RicardoKers/TelemetriaVeiculoEletrico/README.md

# TelemetriaVeiculoEletrico

Projeto da telemetria do veículo elétrico do IFC Luzerna versão 2022
