RicardoKers/TelemetriaVeiculoEletrico/Documentos/Características das entradas.docx

Entradas de tensão

Circuito de teste

Resposta no tempo.

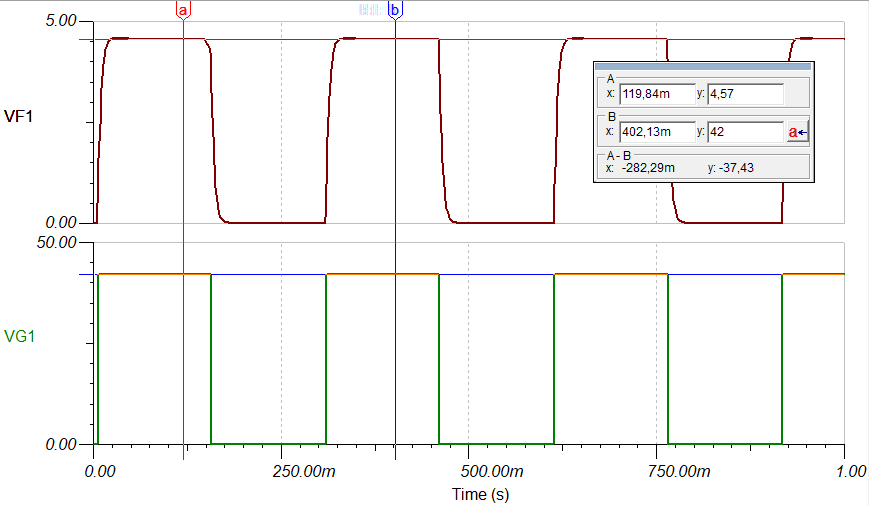
[picture p1: figure]

Resposta em frequência.

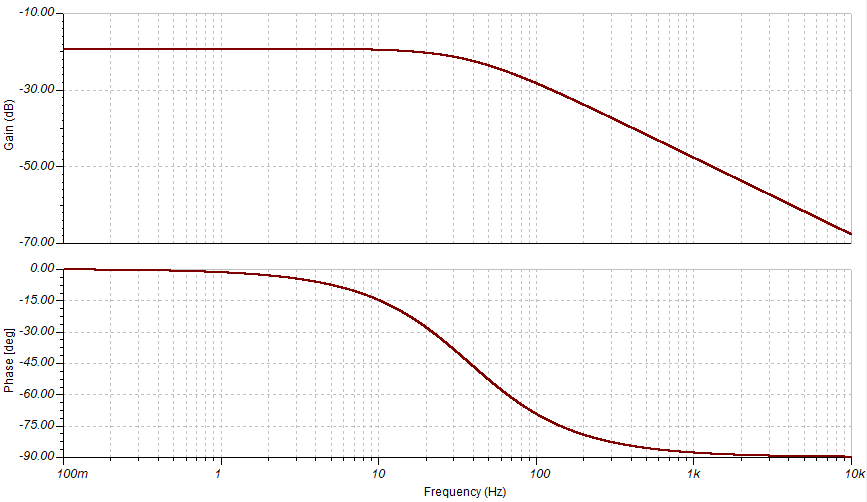
[picture p2: figure]

Entrada de corrente:

Circuito de teste:

Resposta no tempo:

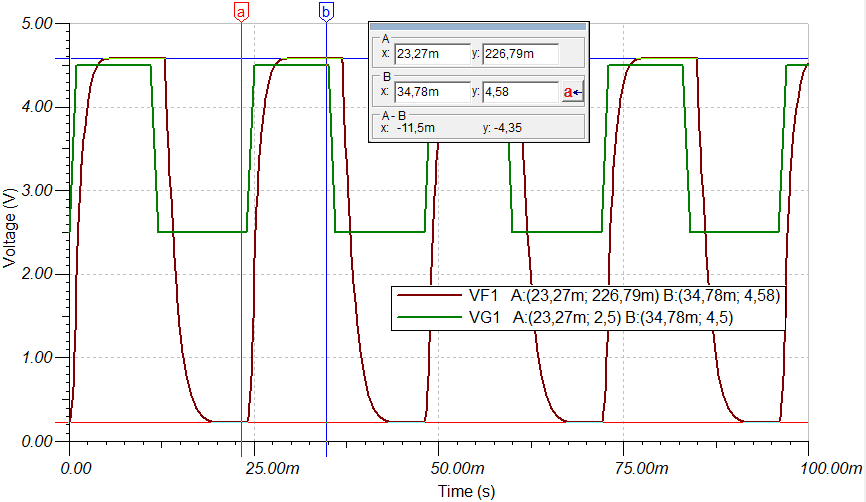
[picture p3: figure]

Resposta em frequência:

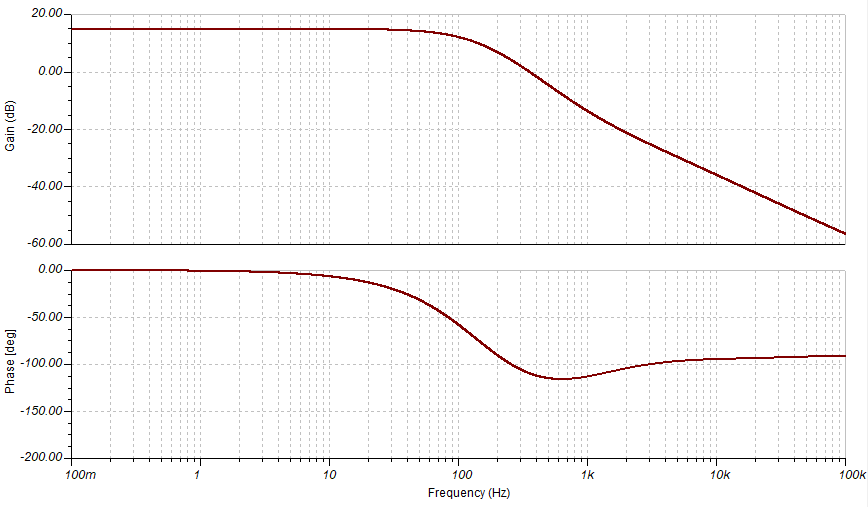
[picture p4: figure]
