RicardoKers/TelemetriaVeiculoEletrico/simulacao/BLDC.png

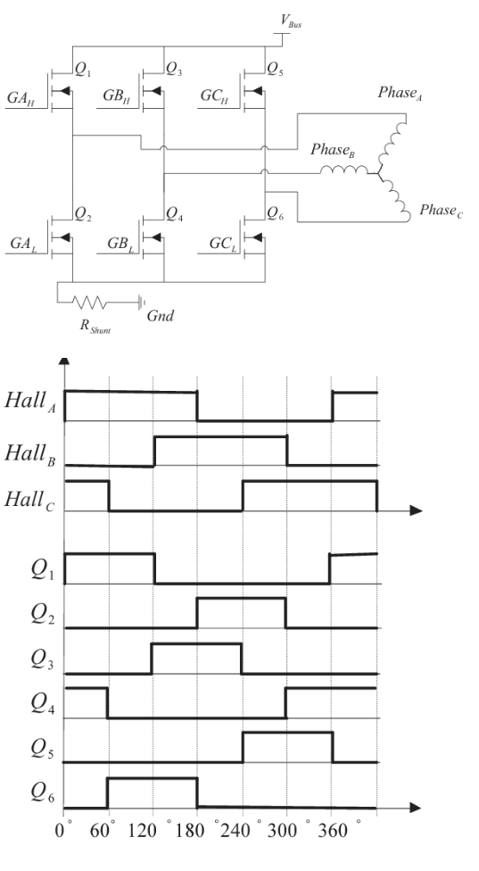
simulacao/BLDC.png
