RicardoKers/TelemetriaVeiculoEletrico/Documentos/Projeto LM2576.pdf

## WEBENCH ® Design Report

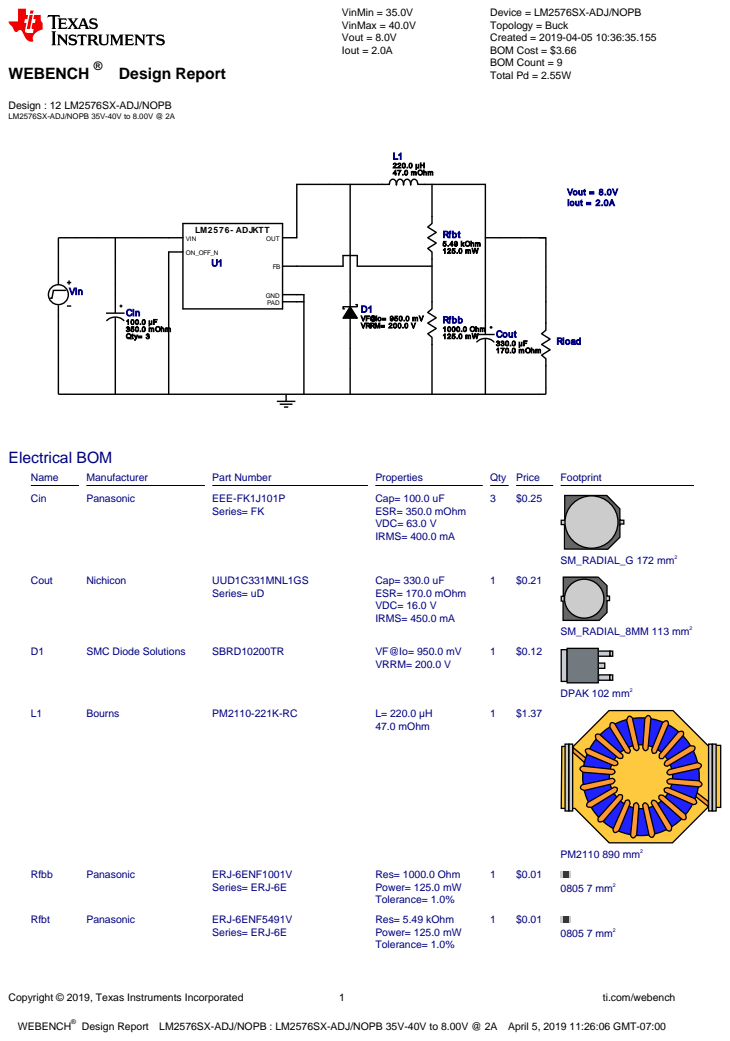
[picture p11: page 1]
Copyright © 2019, Texas Instruments Incorporated; ti.com/webench; WEBENCH®; VinMin = 35.0V VinMax = 40.0V Vout = 8.0V Iout = 2.0A; Cin 100.0 µF 350.0 mOhm; Qty= 3; Cout; 330.0 µF 170.0 mOhm; D1 VF@Io= 950.0 mV VRRM= 200.0 V; L1 220.0 µH 47.0 mOhm; Rfbb 1000.0 Ohm 125.0 mW; Rfbt 5.49 kOhm 125.0 mW; LM2576- ADJKTT; VIN; OUT; GND; ON_OFF_N; PAD; Vout = 8.0V Iout = 2.0A; Vin; Rload; Electrical BOM; Name; Manufacturer; Part Number; Properties; Qty Price; Footprint; Cin; Panasonic; EEE-FK1J101P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

Device = LM2576SX-ADJ/NOPB
Topology = Buck
Created = 2019-04-05 10:36:35.155
BOM Cost = $3.66
BOM Count = 9
Total Pd = 2.55W

Design : 12 LM2576SX-ADJ/NOPB
LM2576SX-ADJ/NOPB 35V-40V to 8.00V @ 2A

Design Report LM2576SX-ADJ/NOPB : LM2576SX-ADJ/NOPB 35V-40V to 8.00V @ 2A April 5, 2019 11:26:06 GMT-07:00

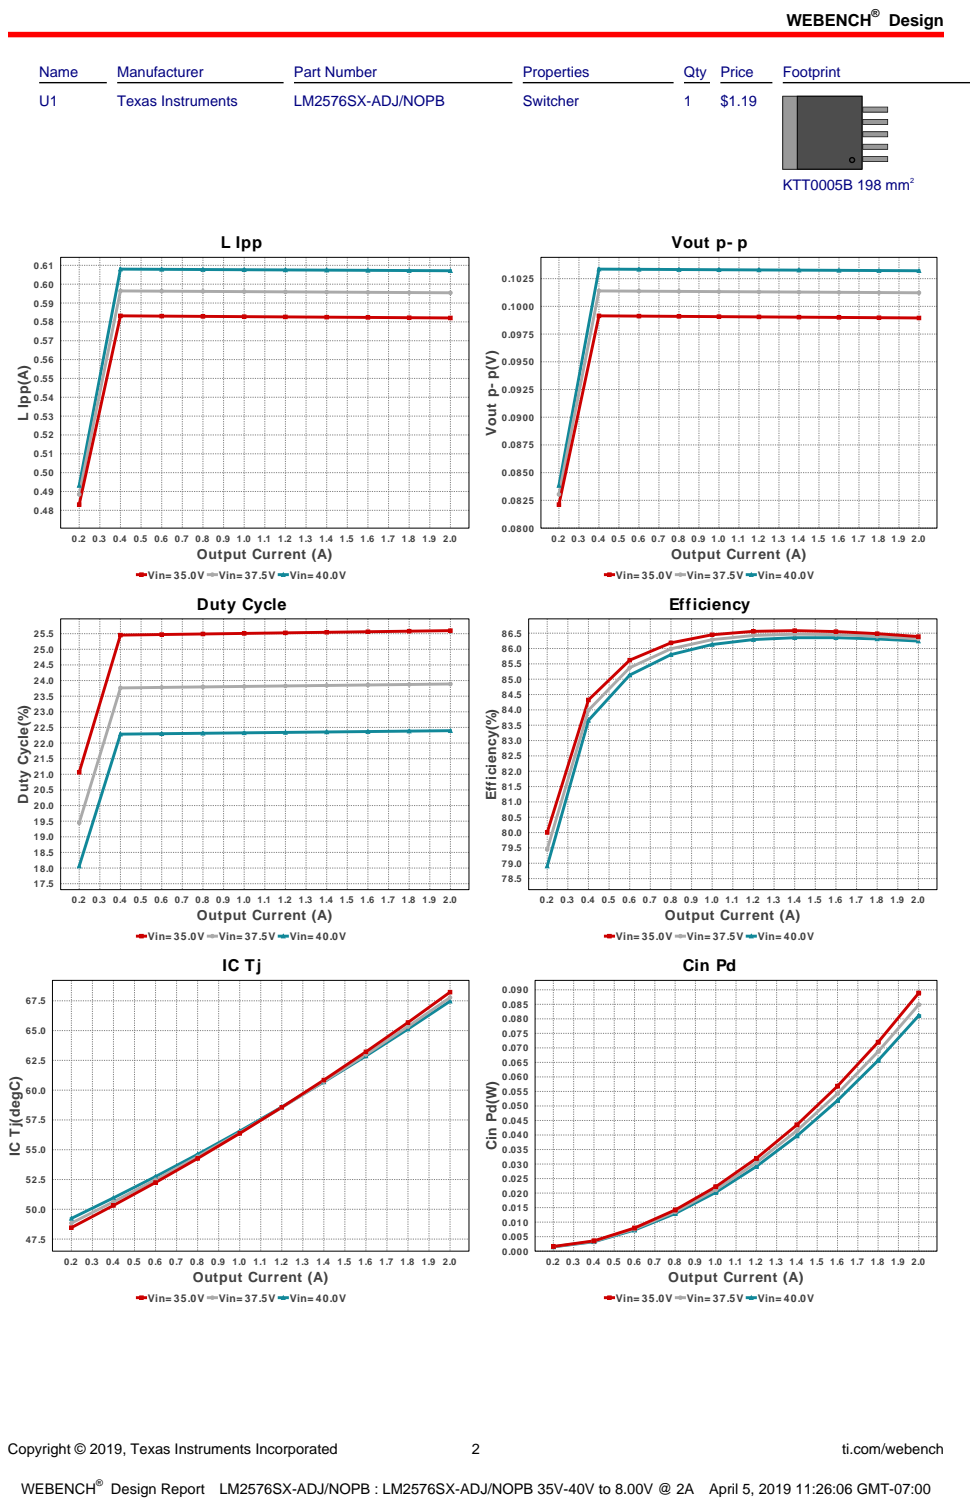
[picture p12: page 2]
Design; Copyright © 2019, Texas Instruments Incorporated; ti.com/webench; Name; Manufacturer; Part Number; Properties; Qty Price; Footprint; Texas Instruments; LM2576SX-ADJ/NOPB; Switcher; KTT0005B 198 mm²; L Ipp; 0.2 0.3 0.4 0.5 0.6 0.7 0.8 0.9 1.0 1.1 1.2 1.3 1.4 1.5 1.6 1.7 1.8 1.9 2.0 Output Current (A); L Ipp(A); Vout p- p; Vout p- p(V); Duty Cycle(%); Efficiency(%); Cin Pd; Cin Pd(W)

Vin= 35.0V Vin= 37.5V Vin= 40.0V
Duty Cycle

Efficiency

IC Tj(degC)

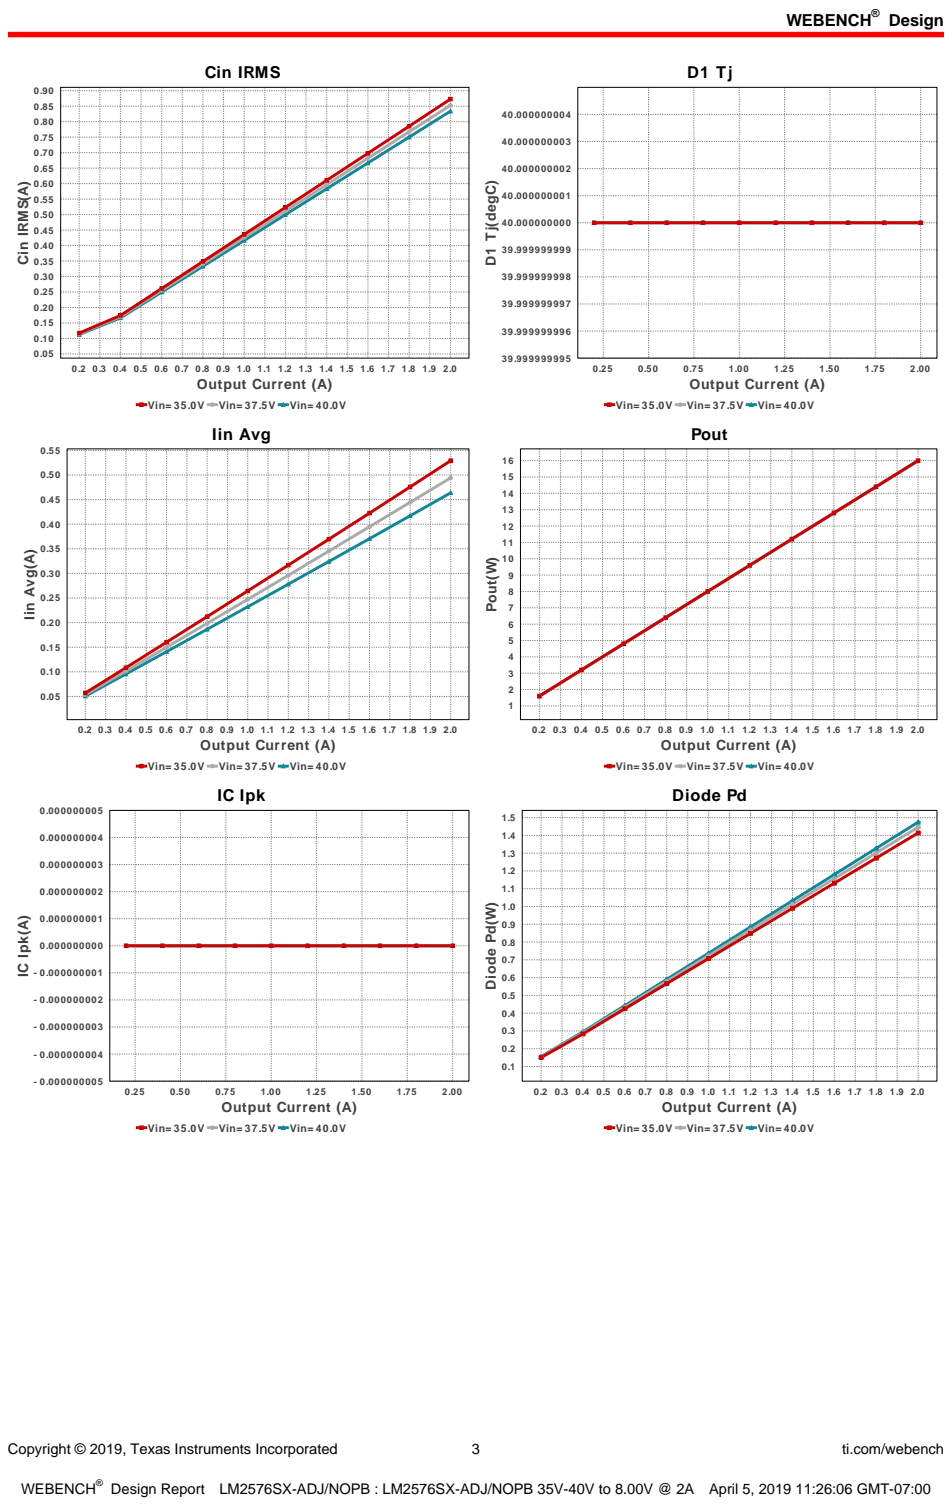
[picture p13: page 3]
Copyright © 2019, Texas Instruments Incorporated; ti.com/webench; Cin IRMS; 0.2 0.3 0.4 0.5 0.6 0.7 0.8 0.9 1.0 1.1 1.2 1.3 1.4 1.5 1.6 1.7 1.8 1.9 2.0 Output Current (A); Cin IRMS(A); 2.00 Output Current (A); D1 Tj(degC); Iin Avg; Iin Avg(A); Pout; Pout(W); IC Ipk; IC Ipk(A); Diode Pd(W)

Vin= 35.0V Vin= 37.5V Vin= 40.0V

Diode Pd

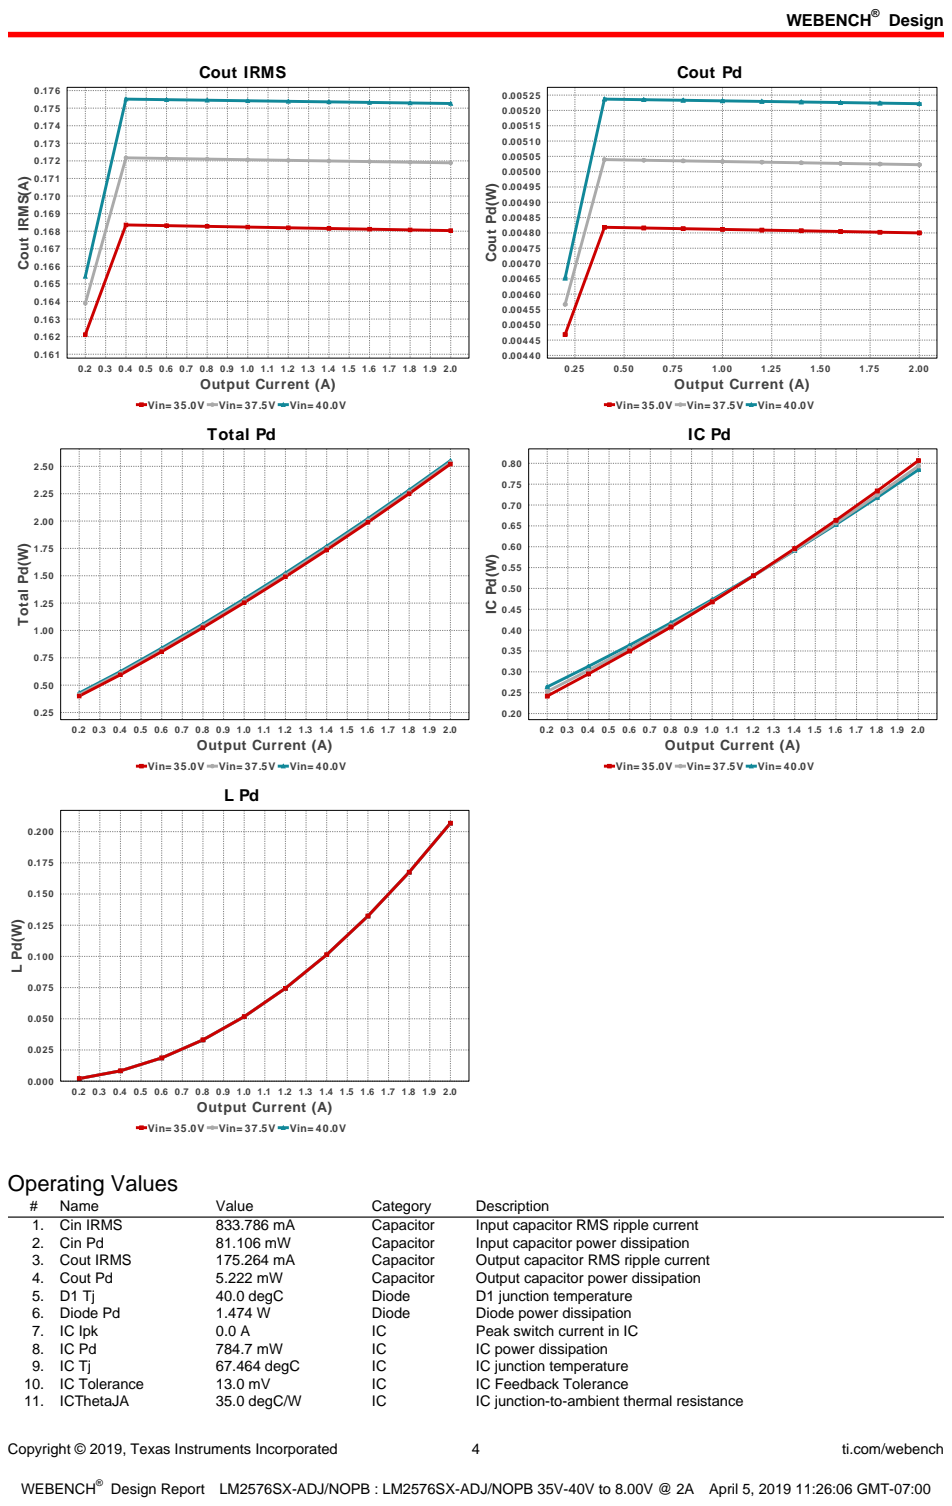
[picture p14: page 4]
Copyright © 2019, Texas Instruments Incorporated; ti.com/webench; Cout IRMS; 0.2 0.3 0.4 0.5 0.6 0.7 0.8 0.9 1.0 1.1 1.2 1.3 1.4 1.5 1.6 1.7 1.8 1.9 2.0 Output Current (A); Cout IRMS(A); Cout Pd; 2.00 Output Current (A); Cout Pd(W); Total Pd; Total Pd(W); Operating Values; Name; Value; Category; Description; 1. Cin IRMS; Capacitor; Input capacitor RMS ripple current; 2. Cin Pd; Input capacitor power dissipation; 3. Cout IRMS; Output capacitor RMS ripple current; 4. Cout Pd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

Vin= 35.0V Vin= 37.5V Vin= 40.0V

Copyright © 2019, Texas Instruments Incorporated | 5 | ti.com/webench
# | Name | Value | Category | Description

12. Iin Avg | 463.81 mA | IC | Average input current
13. L Ipp | 607.13 mA | Inductor | Peak-to-peak inductor ripple current
14. L Pd | 206.8 mW | Inductor | Inductor power dissipation
15. Cin Pd | 81.106 mW | Power | Input capacitor power dissipation
16. Cout Pd | 5.222 mW | Power | Output capacitor power dissipation
17. Diode Pd | 1.474 W | Power | Diode power dissipation
18. IC Pd | 784.7 mW | Power | IC power dissipation
19. L Pd | 206.8 mW | Power | Inductor power dissipation
20. Total Pd | 2.552 W | Power | Total Power Dissipation
21. BOM Count | 9 | System
| | | Information | Total Design BOM count
22. Duty Cycle | 22.396 % | System
| | | Information | Duty cycle
23. Efficiency | 86.243 % | System
| | | Information | Steady state efficiency
24. FootPrint | 1.834 k mm² | System
| | | Information | Total Foot Print Area of BOM components
25. Frequency | 52.0 kHz | System
| | | Information | Switching frequency
26. Iout | 2.0 A | System
| | | Information | Iout operating point
27. Mode | CCM | System
| | | Information | Conduction Mode
28. Pout | 16.0 W | System
| | | Information | Total output power
29. Total BOM | $3.66 | System
| | | Information | Total BOM Cost
30. Vin | 40.0 V | System
| | | Information | Vin operating point
31. Vout | 8.0 V | System
| | | Information | Operational Output Voltage
32. Vout Actual | 7.983 V | System
| | | Information | Vout Actual calculated based on selected voltage divider resistors
33. Vout Tolerance | 2.784 % | System
| | | Information | Vout Tolerance based on IC Tolerance (no load) and voltage divider resistors if applicable
34. Vout p-p | 103.213 mV | System
| | | Information | Peak-to-peak output ripple voltage

## Design Inputs

Name | Value | Description
Iout | 2.0 | Maximum Output Current
VinMax | 40.0 | Maximum input voltage
VinMin | 35.0 | Minimum input voltage
Vout | 8.0 | Output Voltage
| base_pn | | LM2576 | Base Product Number
source | DC | Input Source Type
Ta | 40.0 | Ambient temperature


Copyright © 2019, Texas Instruments Incorporated | 6 | ti.com/webench

## Assembly

## Component Testing

Some published data on components in datasheets such as Capacitor ESR and Inductor DC resistance is based on conservative values that will guarantee that the components always exceed the specification. For design purposes it is usually better to work with typical values. Since this data is not always available it is a good practice to measure the Capacitance and ESR values of Cin and Cout, and the inductance and DC resistance of L1 before assembly of the board. Any large discrepancies in values should be electrically simulated in WEBENCH to check for instabilities and thermally simulated in WebTHERM to make sure critical temperatures are not exceeded.

## Soldering Component to Board

If board assembly is done in house it is best to tack down one terminal of a component on the board then solder the other terminal. For surface mount parts with large tabs, such as the DPAK, the tab on the back of the package should be pre-tinned with solder, then tacked into place by one of the pins. To solder the tab town to the board place the iron down on the board while resting against the tab, heating both surfaces simultaneously. Apply light pressure to the top of the plastic case until the solder flows around the part and the part is flush with the PCB. If the solder is not flowing around the board you may need a higher wattage iron (generally 25W to 30W is enough).

## Initial Startup of Circuit

It is best to initially power up the board by setting the input supply voltage to the lowest operating input voltage 35.0V and set the input supply's current limit to zero. With the input supply off connect up the input supply to Vin and GND. Connect a digital volt meter and a load if needed to set the minimum Iout of the design from Vout and GND. Turn on the input supply and slowly turn up the current limit on the input supply.
If the voltage starts to rise on the input supply continue increasing the input supply current limit while watching the output voltage. If the current increases on the input supply, but the voltage remains near zero, then there may be a short or a component misplaced on the board. Power down the board and visually inspect for solder bridges and recheck the diode and capacitor polarities. Once the power supply circuit is operational then more extensive testing may include full load testing, transient load and line tests to compare with simulation results.

## Load Testing

The setup is the same as the initial startup, except that an additional digital voltmeter is connected between Vin and GND, a load is connected between Vout and GND and a current meter is connected in series between Vout and the load. The load must be able to handle at least rated output power + 50% ( 7.5 watts for this design). Ideally the load is supplied in the form of a variable load test unit. It can also be done in the form of suitably large power resistors. When using an oscilloscope to measure waveforms on the prototype board, the ground leads of the oscilloscope probes should be as short as possible and the area of the loop formed by the ground lead should be kept to a minimum. This will help reduce ground lead inductance and eliminate EMI noise that is not actually present in the circuit.

## Design Assistance

1. Master key : F94F151332F15CC5[v1]
2. LM2576 Product Folder : http://www.ti.com/product/LM2576 : contains the data sheet and other resources.

Copyright © 2019, Texas Instruments Incorporated | 7 | ti.com/webench

Important Notice and Disclaimer

TI provides technical and reliability data (including datasheets), design resources (including reference designs), application or other design advice, web tools, safety information, and other resources AS IS and with all faults, and disclaims all warranties. These resources are intended for skilled developers designing with TI products. You are solely responsible for (1) selecting the appropriate TI products for your application, (2) designing, validating and testing your application, and (3) ensuring your application meets applicable standards, and any other safety, security, or other requirements.

These resources are subject to change without notice. TI grants you permission to use these resources only for development of an application that uses the TI products described in the resource. Other reproduction and display of these resources is prohibited. No license is granted to any other TI intellectual property right or to any third party intellectual property right. TI disclaims responsibility for, and you will fully indemnify TI and its representatives against, any claims, damages, costs, losses, and liabilities arising out of your use of these resources.

Providing these resources does not expand or otherwise alter TI's applicable Terms of Sale or other applicable terms available either on ti.com or provided in conjunction with TI products.
