RicardoKers/TelemetriaVeiculoEletrico/Circuito/PlacaAquisicao/PlacaAquisicao.pdf

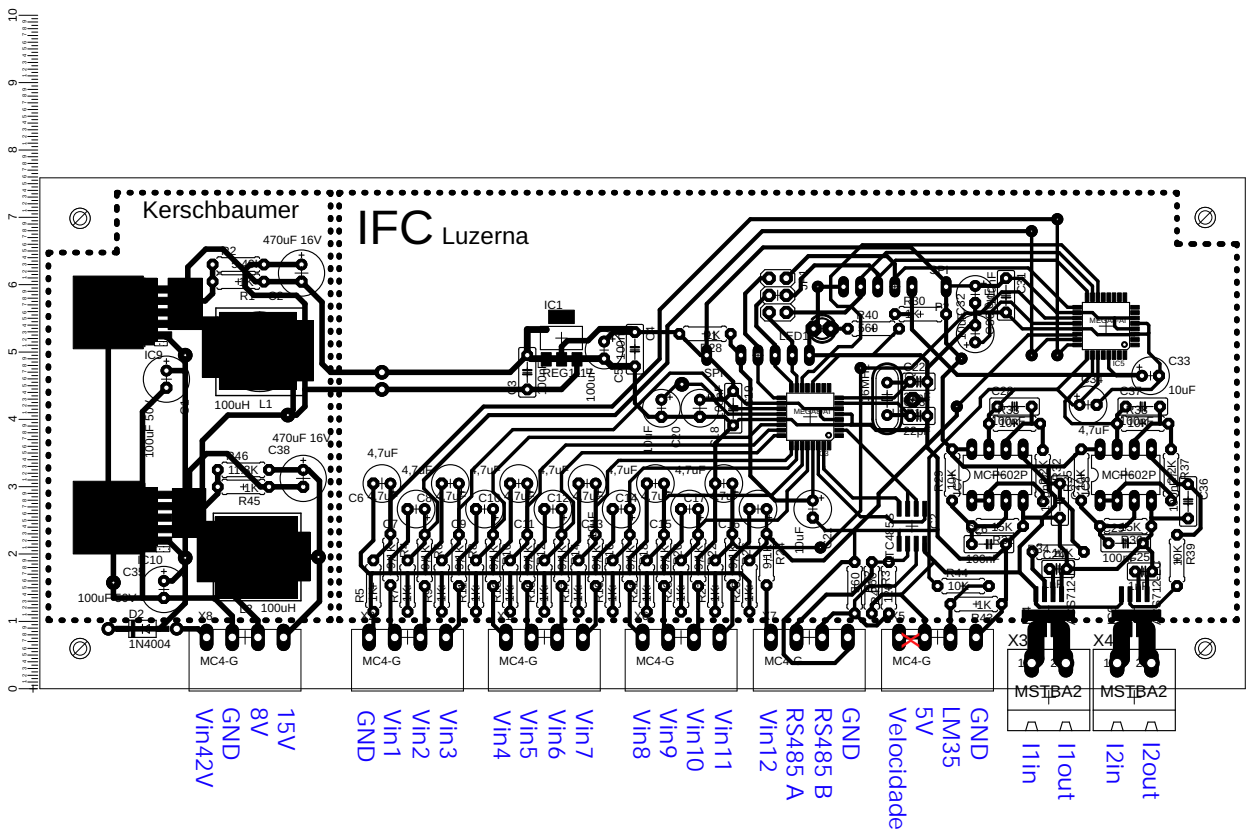
[picture p15: page 1]
