RicardoKers/TelemetriaVeiculoEletrico/(list of files, drawings)

Other design files:
simulacao/BLDC 2.simu
simulacao/BLDC - Copia.simu
simulacao/BLDC velho.simu
simulacao/IHM.simu
