RicardoKers/TelemetriaVeiculoEletrico/Circuito/PlacaPotencia/Final.brd

## EAGLE design Circuito/PlacaPotencia/Final.brd (2022-09-01)

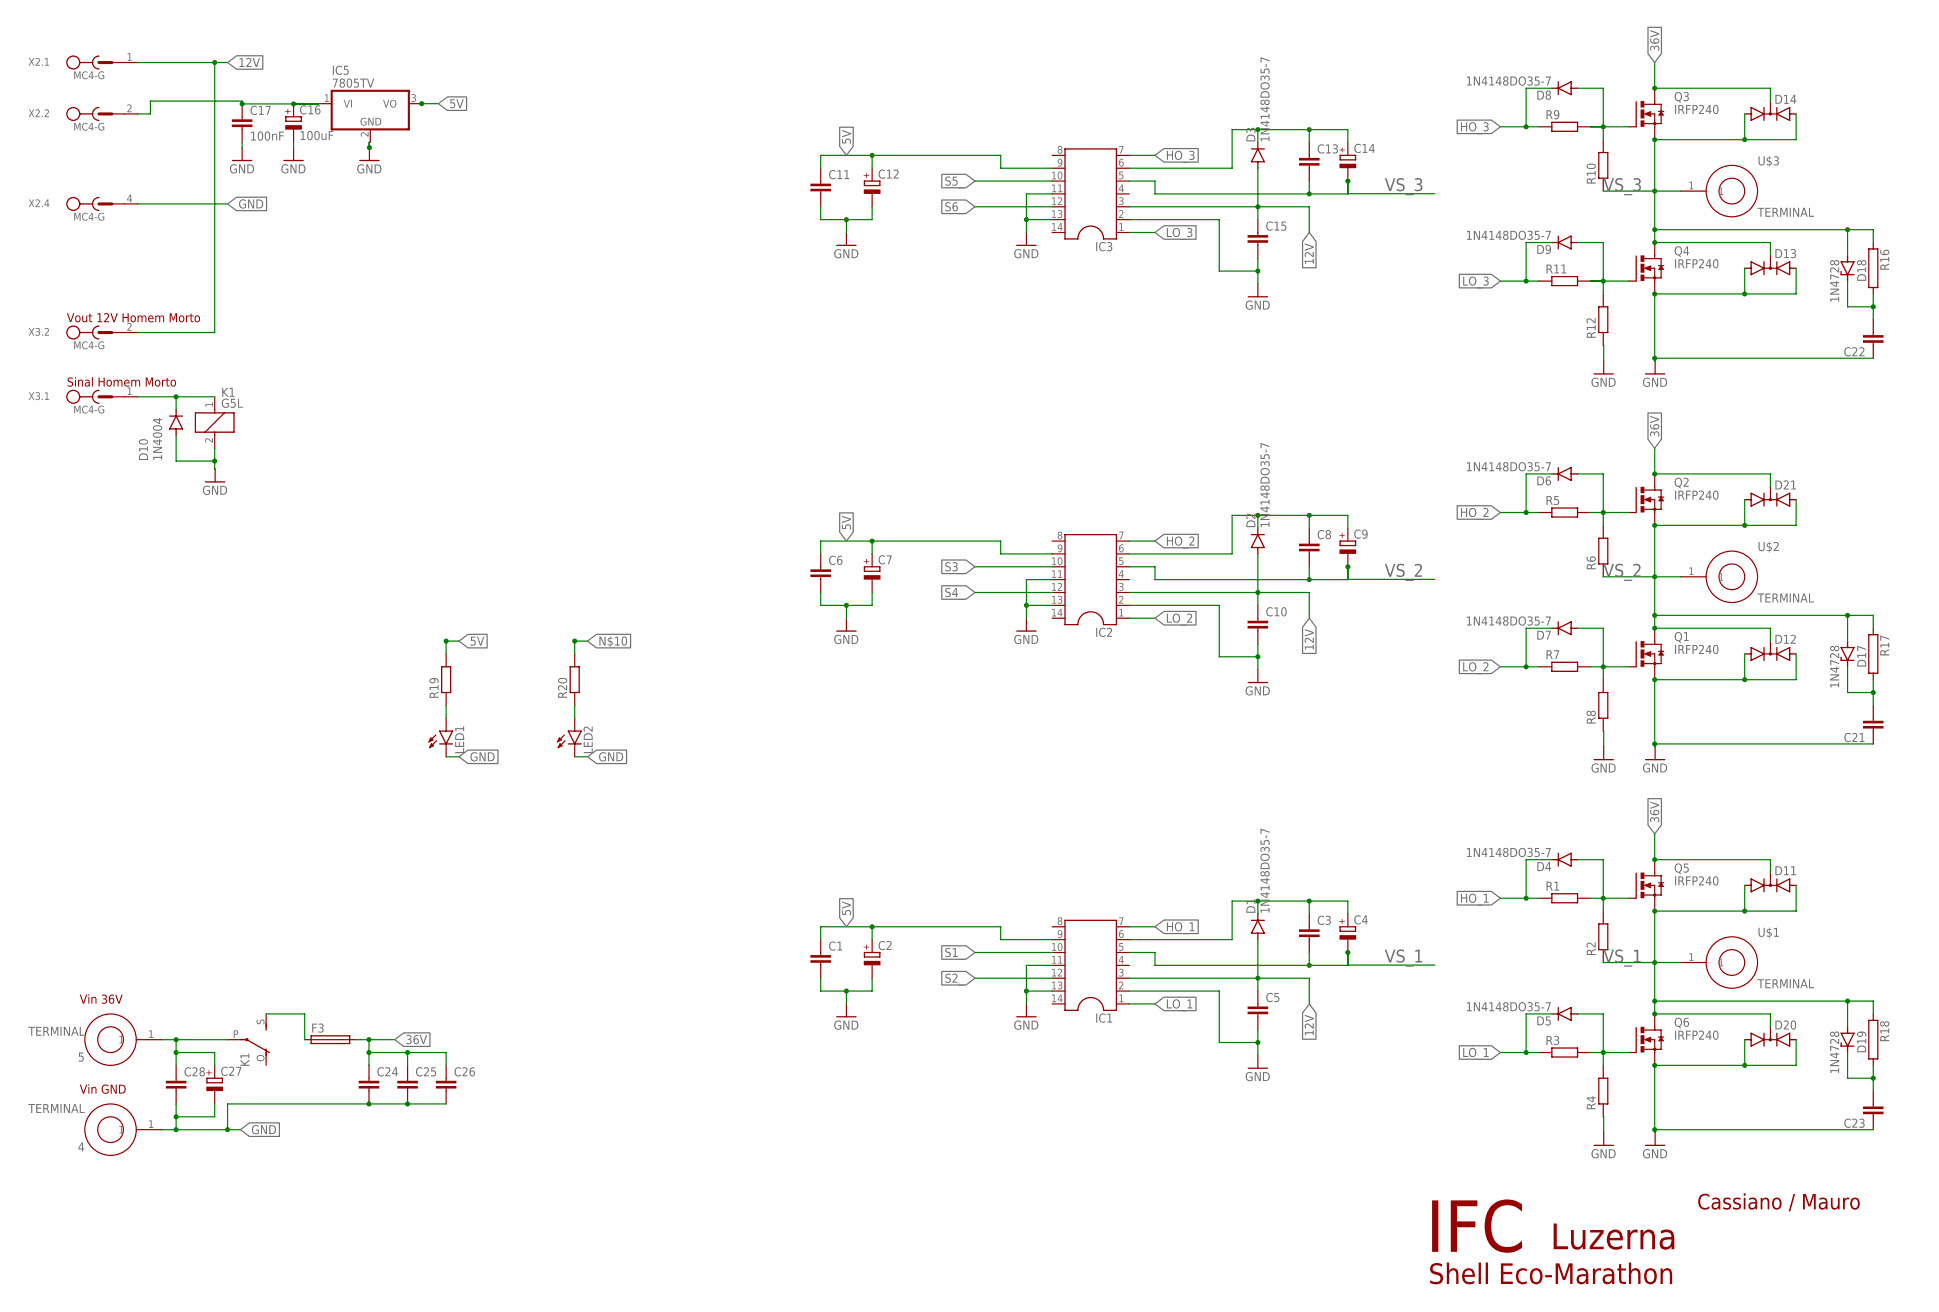
[picture p16: schematic Final.sch, sheet 1]

Parts:
4, 5: TERMINAL
C1, C6, C11: C-EU050-045X075; C050-045X075
C2, C4, C7, C9, C12, C14: CPOL-EUE2.5-7; E2,5-7
C3, C5, C8, C10, C13, C15: C-EU050-025X075; C050-025X075
C16: 100uF; E2,5-7
C17: 100nF; C050-045X075
C21, C22, C23: C-EU150-054X183; C150-054X183
C24, C25, C26, C28: C-EU275-093X316; C275-093X316
C27: CPOL-EUE10-22.5; EB22,5D
D1, D2, D3, D4, D5, D6, D7, D8, D9: 1N4148DO35-7; DO35-7
D10: 1N4004; DO41-10
D11, D12, D13, D14, D20, D21: DIODE-2AC|CATO220V; TO220ABS
D17, D18, D19: 1N4728; DO41Z10
F3: SH22,5A
IC1, IC2, IC3: DIL14
IC5: 7805TV; TO220V
K1: G5L; G5LE
LED1, LED2: LED5MM
Q1, Q2, Q3, Q4, Q5, Q6: IRFP240; TO247BV
R1, R2, R3, R4, R5, R6, R7, R8, R9, R10, R11, R12, R19, R20: R-EU_0204/7; 0204/7
R16, R17, R18: RCA4150; CA4150
U$1, U$2, U$3: TERMINAL
X2, X3: MC4-G

Connections:
5V: C1.1, C2.+, C6.1, C7.+, C11.1, C12.+, IC1.9, IC2.9, IC3.9, IC5.3 (VO), R19.2; also elsewhere on the board
12V: C5.1, C10.1, C15.1, D1.A, D2.A, D3.A, IC1.3, IC2.3, IC3.3, X2.1, X3.2
36V: C24.1, C25.1, C26.1, D11.C, D14.C, D21.C, F3.2, Q2.D, Q3.D, Q5.D
GND: 4.1, C1.2, C2.-, C5.2, C6.2, C7.-, C10.2, C11.2, C12.-, C15.2, C16.-, C17.2, C21.1, C22.1, C23.1, C24.2, C25.2, C26.2, C27.-, C28.2, D10.A, D12.A1, D12.A2, D13.A1, D13.A2, D20.A1, D20.A2, IC1.2, IC1.11, IC1.13, IC2.2, IC2.11, IC2.13, IC3.2, IC3.11, IC3.13, IC5.2 (GND), K1.2, LED1.K (C), LED2.K (C), Q1.S, Q4.S, Q6.S, R4.1, R8.1, R12.1, X2.4; also elsewhere on the board
HO_1: D4.C, IC1.7, R1.1
HO_2: D6.C, IC2.7, R5.1
HO_3: D8.C, IC3.7, R9.1
LO_1: D5.C, IC1.1, R3.1
LO_2: D7.C, IC2.1, R7.1
LO_3: D9.C, IC3.1, R11.1
unnamed: D4.A, Q5.G, R1.2, R2.2
unnamed: D5.A, Q6.G, R3.2, R4.2
unnamed: F3.1, K1.S
unnamed: D6.A, Q2.G, R5.2, R6.2
unnamed: D7.A, Q1.G, R7.2, R8.2
unnamed: D8.A, Q3.G, R9.2, R10.2
unnamed: D9.A, Q4.G, R11.2, R12.2
unnamed: C16.+, C17.1, IC5.1 (VI), X2.2
unnamed: D10.C, K1.1, R20.2, X3.1
unnamed: 5.1, C27.+, C28.1, K1.P
unnamed: LED1.A, R19.1
unnamed: LED2.A, R20.1
unnamed: C22.2, D18.C, R16.2
unnamed: C21.2, D17.C, R17.2
unnamed: C23.2, D19.C, R18.2
S1_: IC1.10; also elsewhere on the board
S2_: IC1.12; also elsewhere on the board
S3_: IC2.10; also elsewhere on the board
S4_: IC2.12; also elsewhere on the board
S5_: IC3.10; also elsewhere on the board
S6_: IC3.12; also elsewhere on the board
VB_1: C3.1, C4.+, D1.C, IC1.6
VB_2: C8.1, C9.+, D2.C, IC2.6
VB_3: C13.1, C14.+, D3.C, IC3.6
VS_1: C3.2, C4.-, D11.A1, D11.A2, D19.A, D20.C, IC1.5, Q5.S, Q6.D, R2.1, R18.1, U$1.1
VS_2: C8.2, C9.-, D12.C, D17.A, D21.A1, D21.A2, IC2.5, Q1.D, Q2.S, R6.1, R17.1, U$2.1
VS_3: C13.2, C14.-, D13.C, D14.A1, D14.A2, D18.A, IC3.5, Q3.S, Q4.D, R10.1, R16.1, U$3.1

Notes on the sheet:
Vout 12V Homem Morto
Sinal Homem Morto
Vin 36V
Vin GND
Shell Eco-Marathon
Cassiano / Mauro
IFC
Luzerna

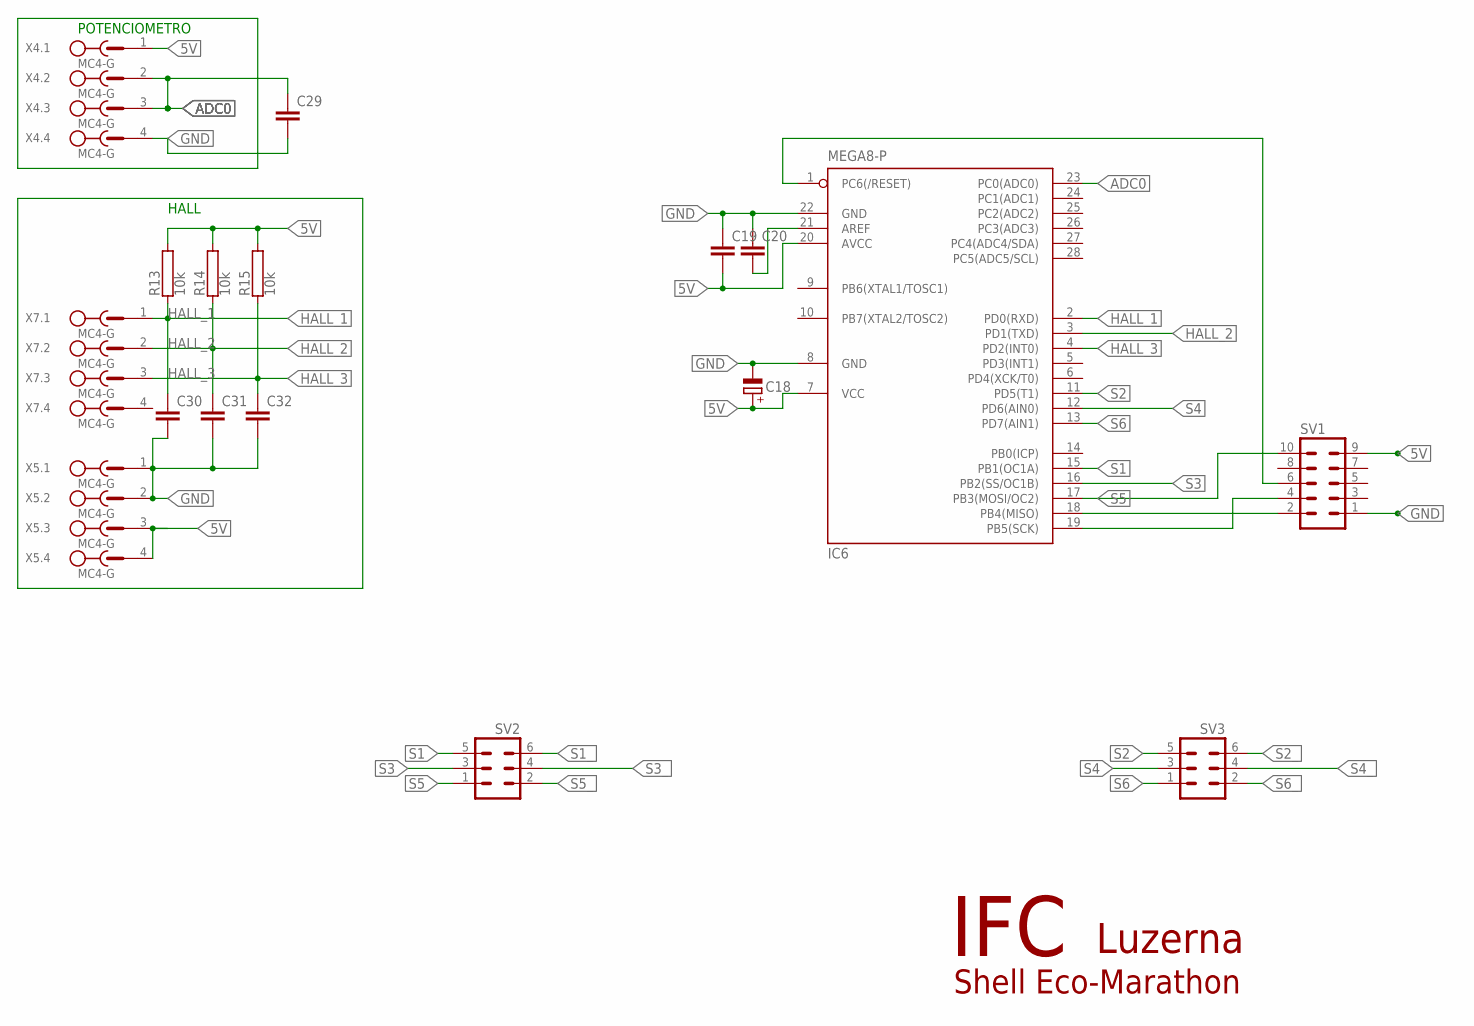
[picture p17: schematic Final.sch, sheet 2]

Parts:
C18: CPOL-EUE3.5-10; E3,5-10
C19, C20, C29, C30, C31, C32: C-EU075-032X103; C075-032X103
IC6: MEGA8-P; DIL28-3
R13, R14, R15: 10k; RS1/4
SV1: MA05-2
SV2, SV3: MA03-2
X4, X5, X7: MC4-G

Connections:
5V: C18.+, C19.2, IC6.7 (VCC), IC6.20 (AVCC), R13.2, R14.2, R15.2, SV1.9, X4.1, X5.3, X5.4; also elsewhere on the board
ADC0: C29.1, IC6.23 (PC0(ADC0)), X4.2, X4.3
GND: C18.-, C19.1, C20.1, C29.2, C30.2, C31.2, C32.2, IC6.8 (GND), IC6.22 (GND), SV1.1, X4.4, X5.1, X5.2; also elsewhere on the board
HALL_1: C30.1, IC6.2 (PD0(RXD)), R13.1, X7.1
HALL_2: C31.1, IC6.3 (PD1(TXD)), R14.1, X7.2
HALL_3: C32.1, IC6.4 (PD2(INT0)), R15.1, X7.3
unnamed: C20.2, IC6.21 (AREF)
unnamed: IC6.19 (PB5(SCK)), SV1.4
unnamed: IC6.18 (PB4(MISO)), SV1.2
unnamed: IC6.1 (PC6(/RESET)), SV1.6
S1: IC6.15 (PB1(OC1A)), SV2.5
S1_: SV2.6; also elsewhere on the board
S2: IC6.11 (PD5(T1)), SV3.5
S2_: SV3.6; also elsewhere on the board
S3: IC6.16 (PB2(SS/OC1B)), SV2.3
S3_: SV2.4; also elsewhere on the board
S4: IC6.12 (PD6(AIN0)), SV3.3
S4_: SV3.4; also elsewhere on the board
S5: IC6.17 (PB3(MOSI/OC2)), SV1.10, SV2.1
S5_: SV2.2; also elsewhere on the board
S6: IC6.13 (PD7(AIN1)), SV3.1
S6_: SV3.2; also elsewhere on the board

Notes on the sheet:
POTENCIOMETRO
HALL
Shell Eco-Marathon
IFC
Luzerna

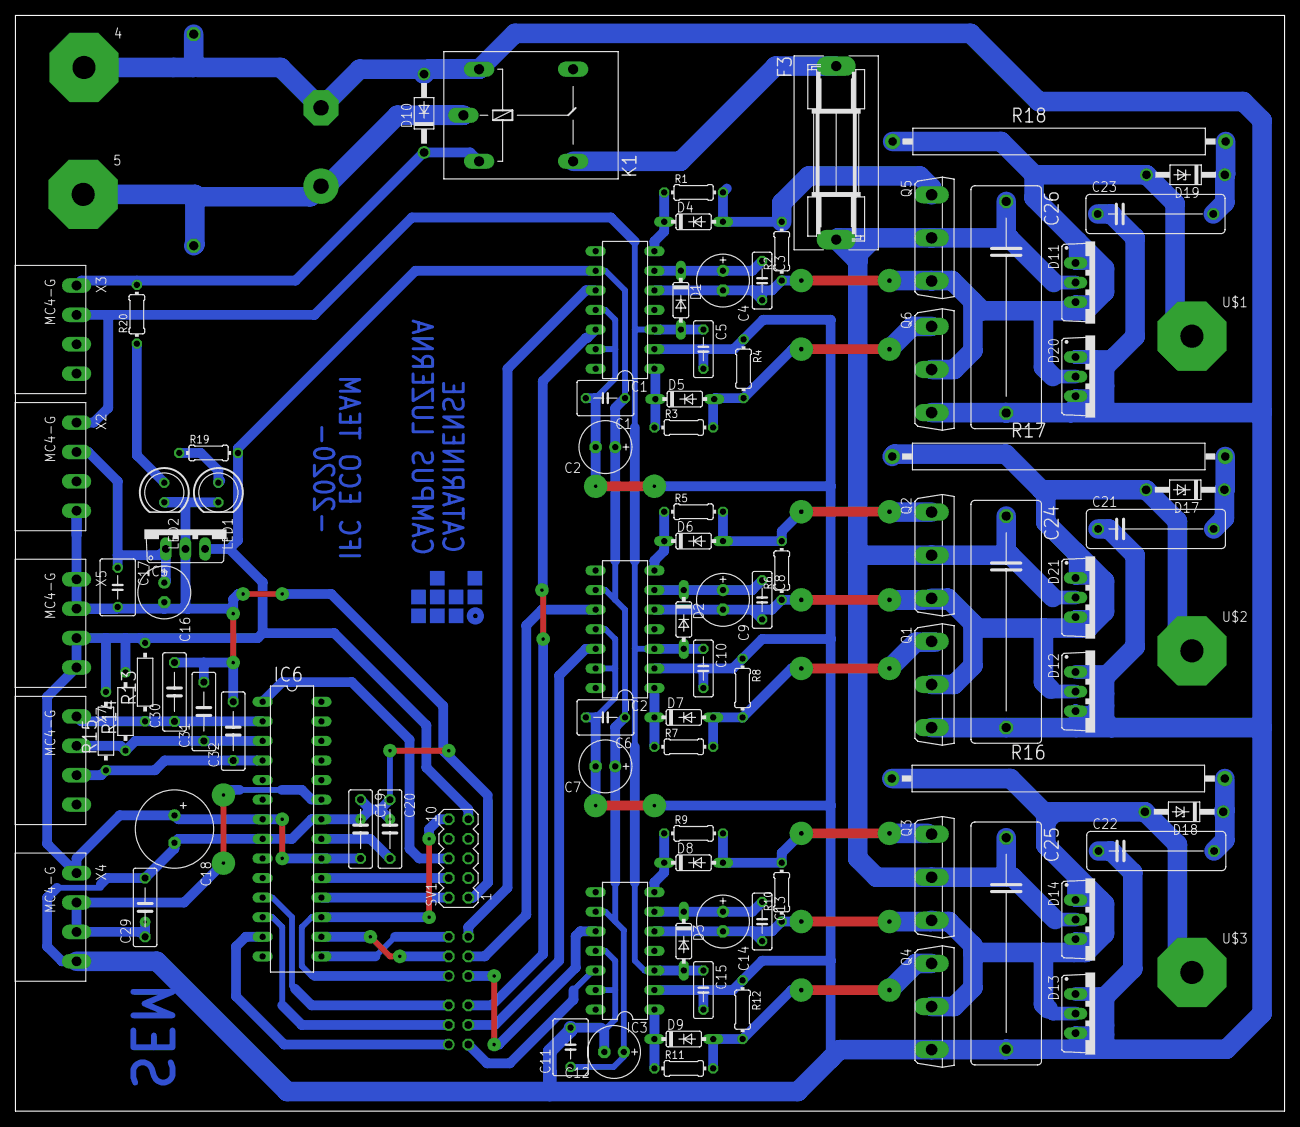
[picture p18: board Final.brd from above]

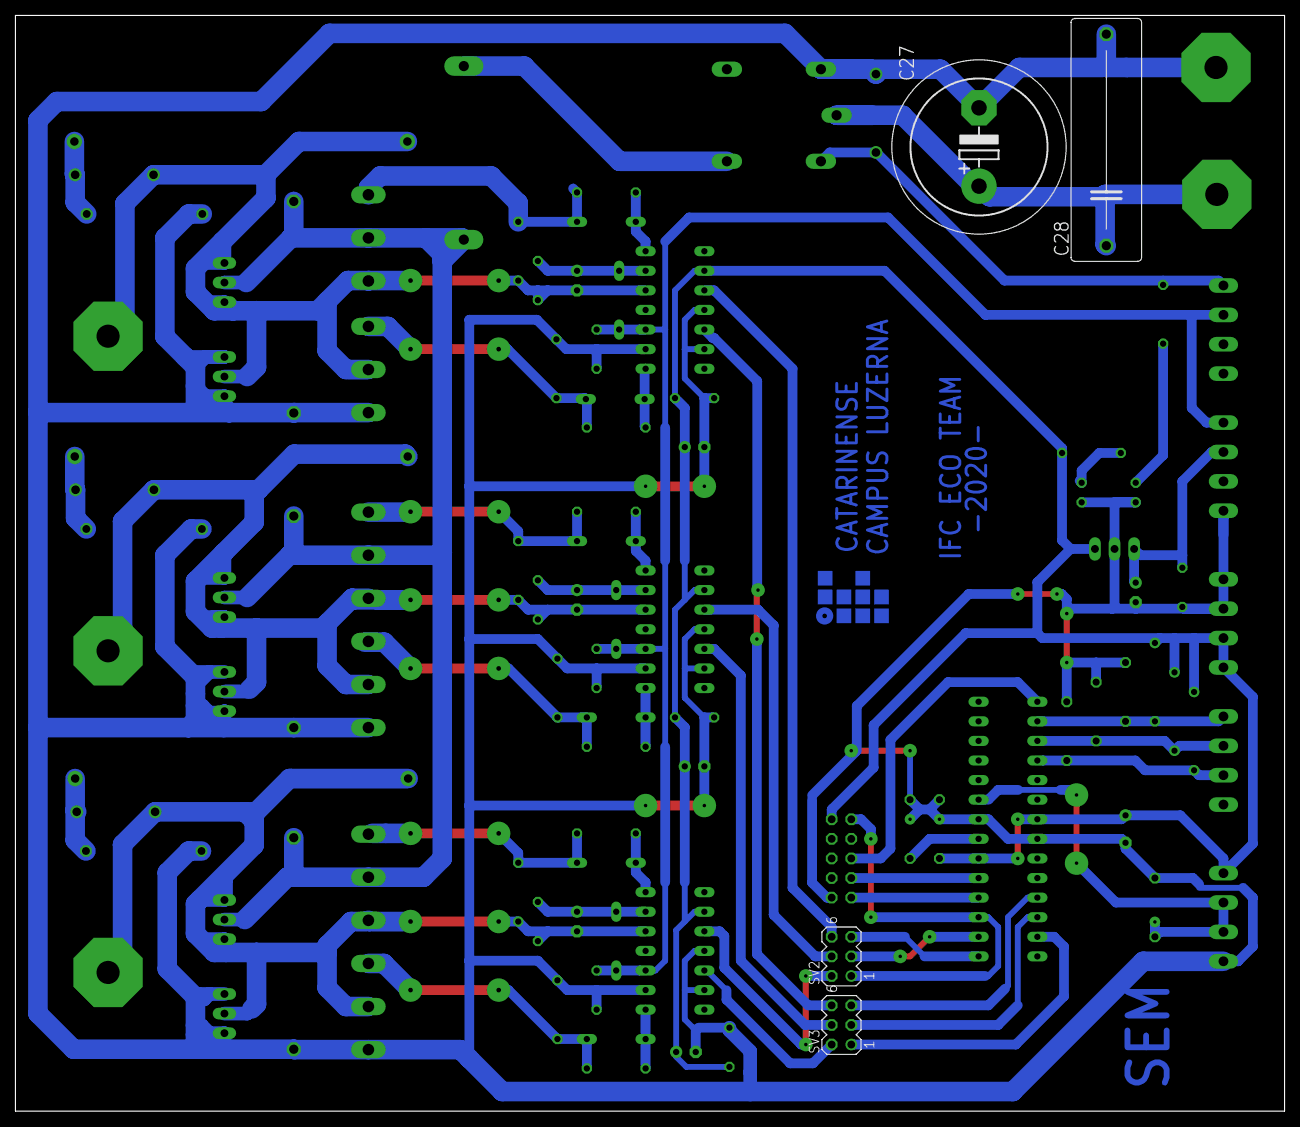
[picture p19: board Final.brd from below]

Board: 2 copper layers, 164.6 x 142.1 mm, 99 parts (4 on the bottom side), 51 nets.
