RicardoKers/TelemetriaVeiculoEletrico/Circuito/PlacaAquisicao/PlacaAquisicao.brd

## EAGLE design Circuito/PlacaAquisicao/PlacaAquisicao.brd (2022-08-31)

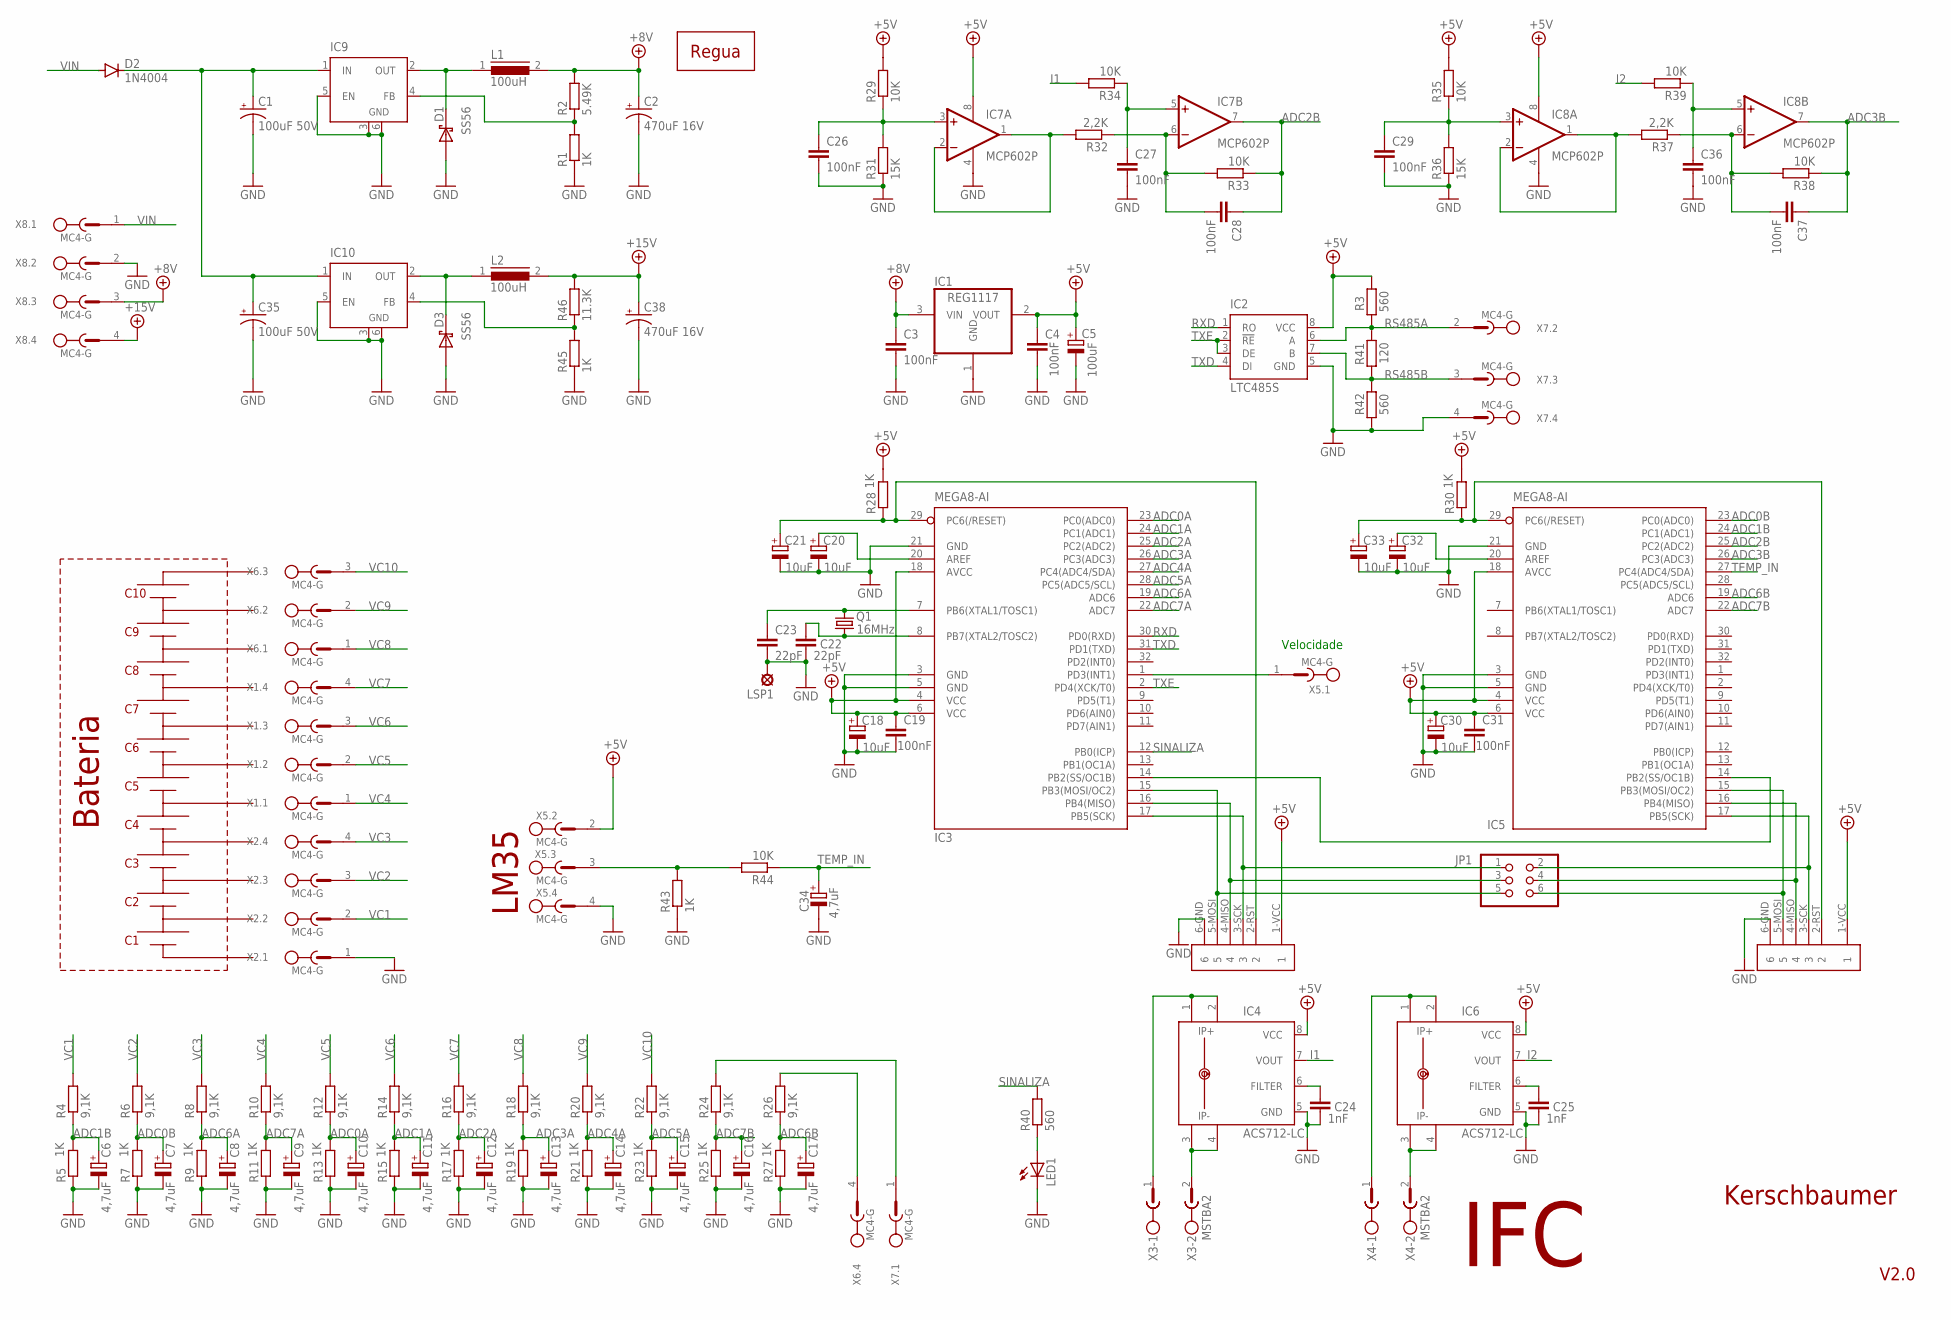
[picture p20: schematic PlacaAquisicao.sch, sheet 1]

Parts:
C1, C35: 100uF 50V; E2,5-7
C2, C38: 470uF 16V; E2,5-7
C3, C4, C19, C26, C27, C28, C29, C31, C36, C37: 100nF; C050-025X075
C5: 100uF; E2,5-6
C6, C7, C8, C9, C10, C11, C12, C13, C14, C15, C16, C17, C34: 4,7uF; E2,5-6
C18, C20, C21, C30, C32, C33: 10uF; E2,5-6
C22, C23: 22pF; C025-025X050
C24, C25: 1nF; C025-025X050
D1, D3: SS56; SMA-DIODE
D2: 1N4004; DO41-10
IC1: REG1117; SOT223
IC2: LTC485S; SOIC8
IC3, IC5: MEGA8-AI; TQFP32-08
IC4, IC6: ACS712-LC; SOIC8
IC7, IC8: MCP602P; DIL08
IC9, IC10: LM2596S; TO263-5
JP1: PINHD-2X3; 2X03
L1, L2: 100uH; DR125
LED1: LED3MM
LSP1: LSP10
P1, P2: SPI
Q1: 16MHz; HC49/S
R1, R5, R7, R9, R11, R13, R15, R17, R19, R21, R23, R25, R27, R28, R30, R43, R45: 1K; 0207/7
R2: 5.49K; 0207/7
R3, R40, R42: 560; 0207/7
R4, R6, R8, R10, R12, R14, R16, R18, R20, R22, R24, R26: 9,1K; 0207/7
R29, R33, R34, R35, R38, R39, R44: 10K; 0207/7
R31, R36: 15K; 0207/7
R32, R37: 2,2K; 0207/7
R41: 120; 0207/7
R46: 11.3K; 0207/7
U$1: REGUA
X1, X2, X5, X6, X7, X8: MC4-G
X3, X4: MSTBA2

Connections:
+5V: C4.1, C5.+, C18.+, C19.1, C30.+, C31.1, IC1.2 (VOUT), IC2.8 (VCC), IC3.4 (VCC), IC3.6 (VCC), IC3.18 (AVCC), IC4.8 (VCC), IC5.4 (VCC), IC5.6 (VCC), IC5.18 (AVCC), IC6.8 (VCC), IC7.8 (V+), IC8.8 (V+), P1.1-VCC (1), P2.1-VCC (1), R3.2, R28.2, R29.2, R30.2, R35.2, X5.2
+8V: C2.+, C3.1, IC1.3 (VIN), L1.2, R2.2, X8.3
+15V: C38.+, L2.2, R46.2, X8.4
ADC0A: C10.+, IC3.23 (PC0(ADC0)), R12.1, R13.2
ADC0B: C7.+, IC5.23 (PC0(ADC0)), R6.1, R7.2
ADC1A: C11.+, IC3.24 (PC1(ADC1)), R14.1, R15.2
ADC1B: C6.+, IC5.24 (PC1(ADC1)), R4.1, R5.2
ADC2A: C12.+, IC3.25 (PC2(ADC2)), R16.1, R17.2
ADC2B: C28.1, IC5.25 (PC2(ADC2)), IC7.7 (OUT), R33.1
ADC3A: C13.+, IC3.26 (PC3(ADC3)), R18.1, R19.2
ADC3B: C37.1, IC5.26 (PC3(ADC3)), IC8.7 (OUT), R38.1
ADC4A: C14.+, IC3.27 (PC4(ADC4/SDA)), R20.1, R21.2
ADC5A: C15.+, IC3.28 (PC5(ADC5/SCL)), R22.1, R23.2
ADC6A: C8.+, IC3.19 (ADC6), R8.1, R9.2
ADC6B: C17.+, IC5.19 (ADC6), R26.1, R27.2
ADC7A: C9.+, IC3.22 (ADC7), R10.1, R11.2
ADC7B: C16.+, IC5.22 (ADC7), R24.1, R25.2
GND: C1.-, C2.-, C3.2, C4.2, C5.-, C6.-, C7.-, C8.-, C9.-, C10.-, C11.-, C12.-, C13.-, C14.-, C15.-, C16.-, C17.-, C18.-, C19.2, C20.-, C21.-, C22.2, C23.2, C24.2, C25.2, C26.2, C27.2, C29.2, C30.-, C31.2, C32.-, C33.-, C34.-, C35.-, C36.2, C38.-, D1.A, D3.A, IC1.1 (GND), IC2.5 (GND), IC3.3 (GND), IC3.5 (GND), IC3.21 (GND), IC4.5 (GND), IC5.3 (GND), IC5.5 (GND), IC5.21 (GND), IC6.5 (GND), IC7.4 (V-), IC8.4 (V-), IC9.3 (GND), IC9.5 (EN), IC9.6 (GND), IC10.3 (GND), IC10.5 (EN), IC10.6 (GND), LED1.K (C), LSP1.MP, P1.6-GND (6), P2.6-GND (6), R1.1, R5.1, R7.1, R9.1, R11.1, R13.1, R15.1, R17.1, R19.1, R21.1, R23.1, R25.1, R27.1, R31.1, R36.1, R42.1, R43.1, R45.1, X2.1, X5.4, X7.4, X8.2
I1: IC4.7 (VOUT), R34.2
I2: IC6.7 (VOUT), R39.2
unnamed: C1.+, C35.+, D2.C, IC9.1 (IN), IC10.1 (IN)
unnamed: IC9.4 (FB), R1.2, R2.1
unnamed: D1.C, IC9.2 (OUT), L1.1
unnamed: C20.+, IC3.20 (AREF)
unnamed: IC3.14 (PB2(SS/OC1B)), IC5.14 (PB2(SS/OC1B))
unnamed: C23.1, IC3.7 (PB6(XTAL1/TOSC1)), Q1.2
unnamed: C22.1, IC3.8 (PB7(XTAL2/TOSC2)), Q1.1
unnamed: C21.+, IC3.29 (PC6(/RESET)), P1.2-RST (2), R28.1
unnamed: IC4.3 (IP-), IC4.4 (IP-1), X3.2
unnamed: R26.2, X6.4
unnamed: IC6.3 (IP-), IC6.4 (IP-1), X4.2
unnamed: IC6.1 (IP+), IC6.2 (IP+1), X4.1
unnamed: C24.1, IC4.6 (FILTER)
unnamed: C32.+, IC5.20 (AREF)
unnamed: IC3.17 (PB5(SCK)), JP1.1, P1.3-SCK (3)
unnamed: IC3.16 (PB4(MISO)), JP1.3, P1.4-MISO (4)
unnamed: C33.+, IC5.29 (PC6(/RESET)), P2.2-RST (2), R30.1
unnamed: IC4.1 (IP+), IC4.2 (IP+1), X3.1
unnamed: C25.1, IC6.6 (FILTER)
unnamed: IC3.1 (PD3(INT1)), X5.1
unnamed: R24.2, X7.1
unnamed: IC7.1 (OUT), IC7.2 (-IN), R32.2
unnamed: C26.1, IC7.3 (+IN), R29.1, R31.2
unnamed: C28.2, IC7.6 (-IN), R32.1, R33.2
unnamed: C27.1, IC7.5 (+IN), R34.1
unnamed: IC8.1 (OUT), IC8.2 (-IN), R37.2
unnamed: C29.1, IC8.3 (+IN), R35.1, R36.2
unnamed: C37.2, IC8.6 (-IN), R37.1, R38.2
unnamed: C36.1, IC8.5 (+IN), R39.1
unnamed: IC3.15 (PB3(MOSI/OC2)), JP1.5, P1.5-MOSI (5)
unnamed: LED1.A, R40.1
unnamed: IC5.17 (PB5(SCK)), JP1.2, P2.3-SCK (3)
unnamed: IC5.16 (PB4(MISO)), JP1.4, P2.4-MISO (4)
unnamed: IC5.15 (PB3(MOSI/OC2)), JP1.6, P2.5-MOSI (5)
unnamed: R43.2, R44.2, X5.3
unnamed: IC10.4 (FB), R45.2, R46.1
unnamed: D3.C, IC10.2 (OUT), L2.1
RS485A: IC2.6 (A), R3.1, R41.2, X7.2
RS485B: IC2.7 (B), R41.1, R42.2, X7.3
RXD: IC2.1 (RO), IC3.30 (PD0(RXD))
SINALIZA: IC3.12 (PB0(ICP)), R40.2
TEMP_IN: C34.+, IC5.27 (PC4(ADC4/SDA)), R44.1
TXD: IC2.4 (DI), IC3.31 (PD1(TXD))
TXE: IC2.2 (!RE), IC2.3 (DE), IC3.2 (PD4(XCK/T0))
VC1: R4.2, X2.2
VC2: R6.2, X2.3
VC3: R8.2, X2.4
VC4: R10.2, X1.1
VC5: R12.2, X1.2
VC6: R14.2, X1.3
VC7: R16.2, X1.4
VC8: R18.2, X6.1
VC9: R20.2, X6.2
VC10: R22.2, X6.3
VIN: D2.A, X8.1

Notes on the sheet:
IFC
Kerschbaumer
C10
Bateria
LM35
Velocidade
V2.0

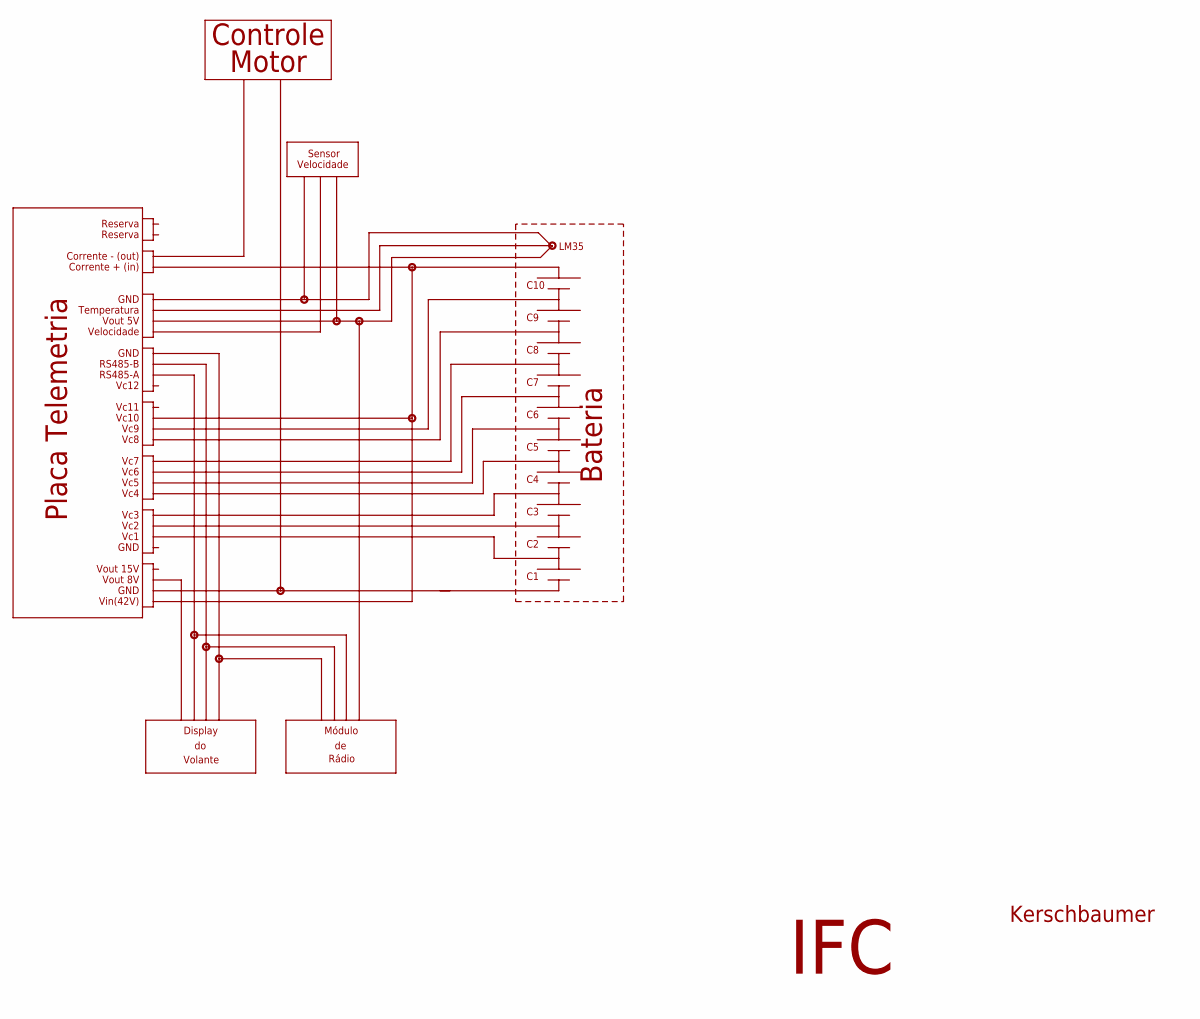
[picture p21: schematic PlacaAquisicao.sch, sheet 2]

Notes on the sheet:
IFC
Kerschbaumer
GND
Temperatura
Vout 5V
Velocidade
RS485-B
RS485-A
Vc12
Vc11
Vc10
Vc9
Vc8
Vc7
Vc6
Vc5
Vc4
Vc3
Vc2
Vc1
Vout 15V
Vout 8V
Vin(42V)
Reserva
Corrente - (out)
Corrente + (in)
Placa Telemetria
C10
Bateria
LM35
Controle
Motor
Sensor
Display
Volante
Módulo
Rádio

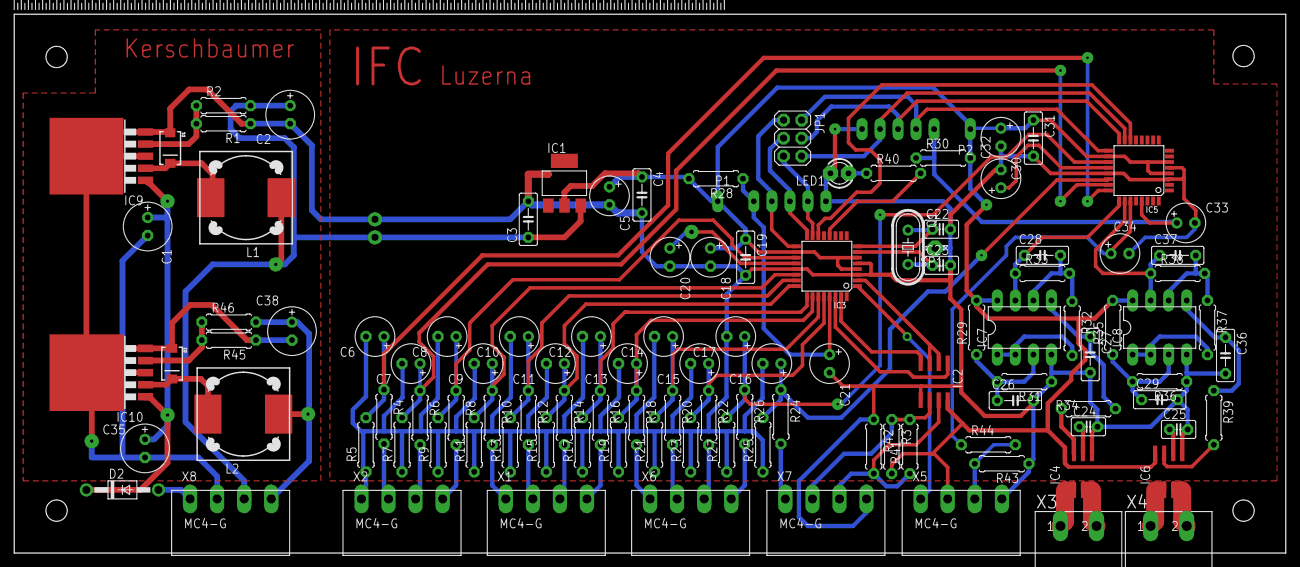
[picture p22: board PlacaAquisicao.brd from above]

Board: 2 copper layers, 179.1 x 75.9 mm, 114 parts (0 on the bottom side), 75 nets.
