RicardoKers/TelemetriaVeiculoEletrico/Circuito/DisplayVolanteVE/DisplayVolanteVE.brd

## EAGLE design Circuito/DisplayVolanteVE/DisplayVolanteVE.brd (2022-08-31)

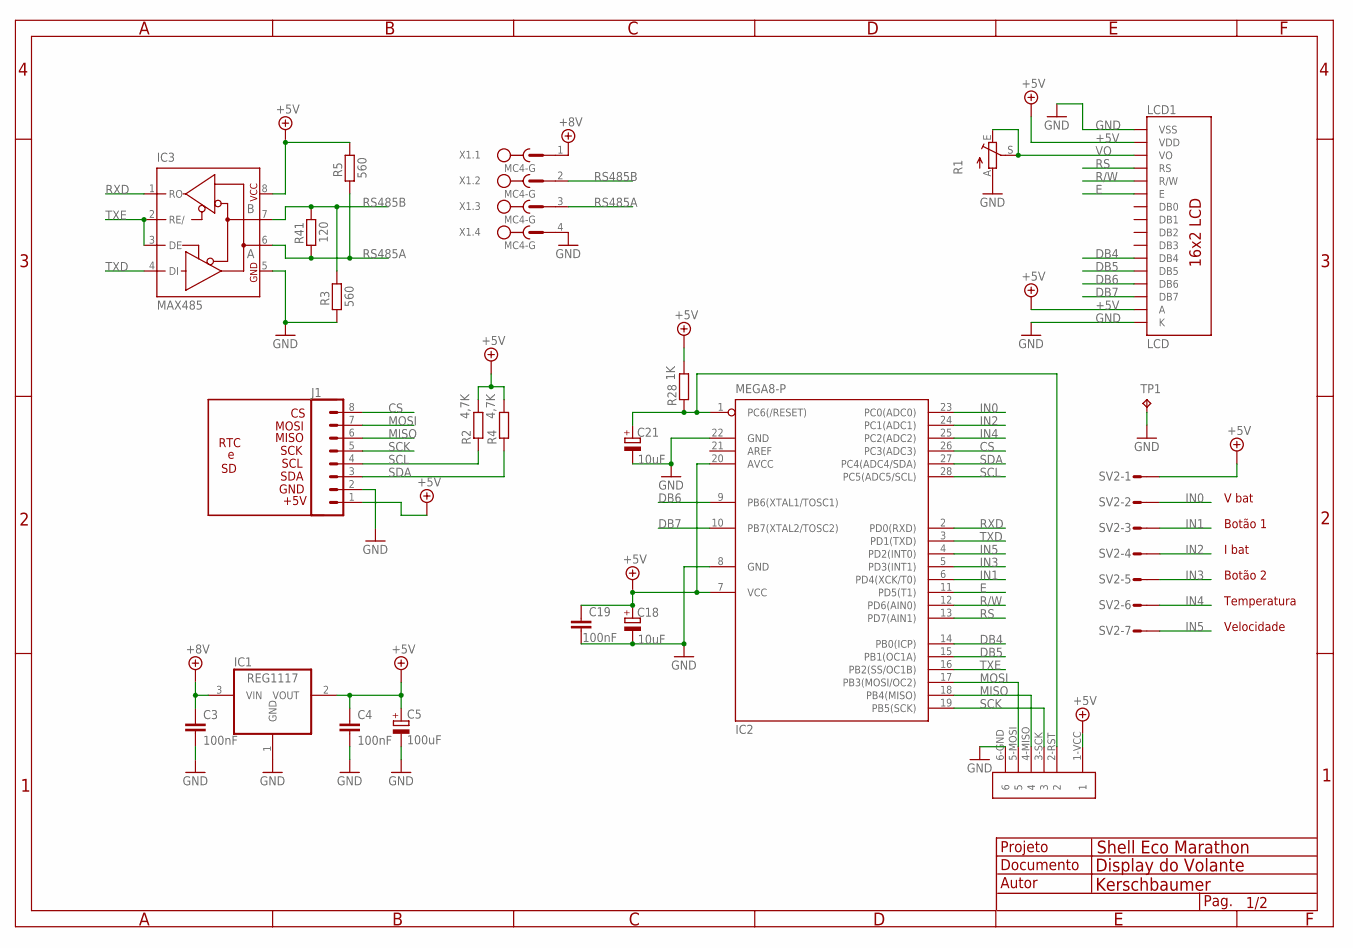
[picture p23: schematic DisplayVolanteVE.sch, sheet 1]

Parts:
C3, C4, C19: 100nF; C050-025X075
C5: 100uF; E2,5-6
C18, C21: 10uF; E2,5-6
IC1: REG1117; SOT223
IC2: MEGA8-P; DIL28-3
IC3: MAX485; DIL08
J1: CONN_08NO_SILK_FEMALE_PTH; 1X08_NO_SILK
LCD1: LCD; LCD-16X2_NOHOLESNOSILK
P1: SPI
R1: TRIM_EU-B64Y; B64Y
R2, R4: 4,7K; 0207/7
R3, R5: 560; 0207/7
R28: 1K; 0207/7
R41: 120; 0207/7
SV2: L07P
TP1: TPPAD1-13; P1-13
X1: MC4-G

Connections:
+5V: C4.1, C5.+, C18.+, C19.1, IC1.2 (VOUT), IC2.7 (VCC), IC2.20 (AVCC), IC3.8 (VCC), J1.1, LCD1.2 (VDD), LCD1.15 (A), P1.1-VCC (1), R2.2, R4.2, R5.2, R28.2, SV2.1
+8V: C3.1, IC1.3 (VIN), X1.1
CS: IC2.26 (PC3(ADC3)), J1.8
DB4: IC2.14 (PB0(ICP)), LCD1.11 (DB4)
DB5: IC2.15 (PB1(OC1A)), LCD1.12 (DB5)
DB6: IC2.9 (PB6(XTAL1/TOSC1)), LCD1.13 (DB6)
DB7: IC2.10 (PB7(XTAL2/TOSC2)), LCD1.14 (DB7)
E: IC2.11 (PD5(T1)), LCD1.6 (E)
GND: C3.2, C4.2, C5.-, C18.-, C19.2, C21.-, IC1.1 (GND), IC2.8 (GND), IC2.22 (GND), IC3.5 (GND), J1.2, LCD1.1 (VSS), LCD1.16 (K), P1.6-GND (6), R1.A, R3.1, TP1.TP, X1.4
IN0: IC2.23 (PC0(ADC0)), SV2.2
IN1: IC2.6 (PD4(XCK/T0)), SV2.3
IN2: IC2.24 (PC1(ADC1)), SV2.4
IN3: IC2.5 (PD3(INT1)), SV2.5
IN4: IC2.25 (PC2(ADC2)), SV2.6
IN5: IC2.4 (PD2(INT0)), SV2.7
MISO: IC2.18 (PB4(MISO)), J1.6, P1.4-MISO (4)
MOSI: IC2.17 (PB3(MOSI/OC2)), J1.7, P1.5-MOSI (5)
unnamed: C21.+, IC2.1 (PC6(/RESET)), P1.2-RST (2), R28.1
R/W: IC2.12 (PD6(AIN0)), LCD1.5 (R/W)
RS: IC2.13 (PD7(AIN1)), LCD1.4 (RS)
RS485A: IC3.6 (A), R5.1, R41.1, X1.3
RS485B: IC3.7 (B), R3.2, R41.2, X1.2
RXD: IC2.2 (PD0(RXD)), IC3.1 (RO)
SCK: IC2.19 (PB5(SCK)), J1.5, P1.3-SCK (3)
SCL: IC2.28 (PC5(ADC5/SCL)), J1.4, R2.1
SDA: IC2.27 (PC4(ADC4/SDA)), J1.3, R4.1
TXD: IC2.3 (PD1(TXD)), IC3.4 (DI)
TXE: IC2.16 (PB2(SS/OC1B)), IC3.2 (RE/), IC3.3 (DE)
VO: LCD1.3 (VO), R1.E, R1.S

Notes on the sheet:
Shell Eco Marathon
Display do Volante
Kerschbaumer
RTC
MOSI
MISO
SCK
SCL
SDA
GND
+5V
Botão 1
V bat
I bat
Botão 2
Temperatura
Velocidade

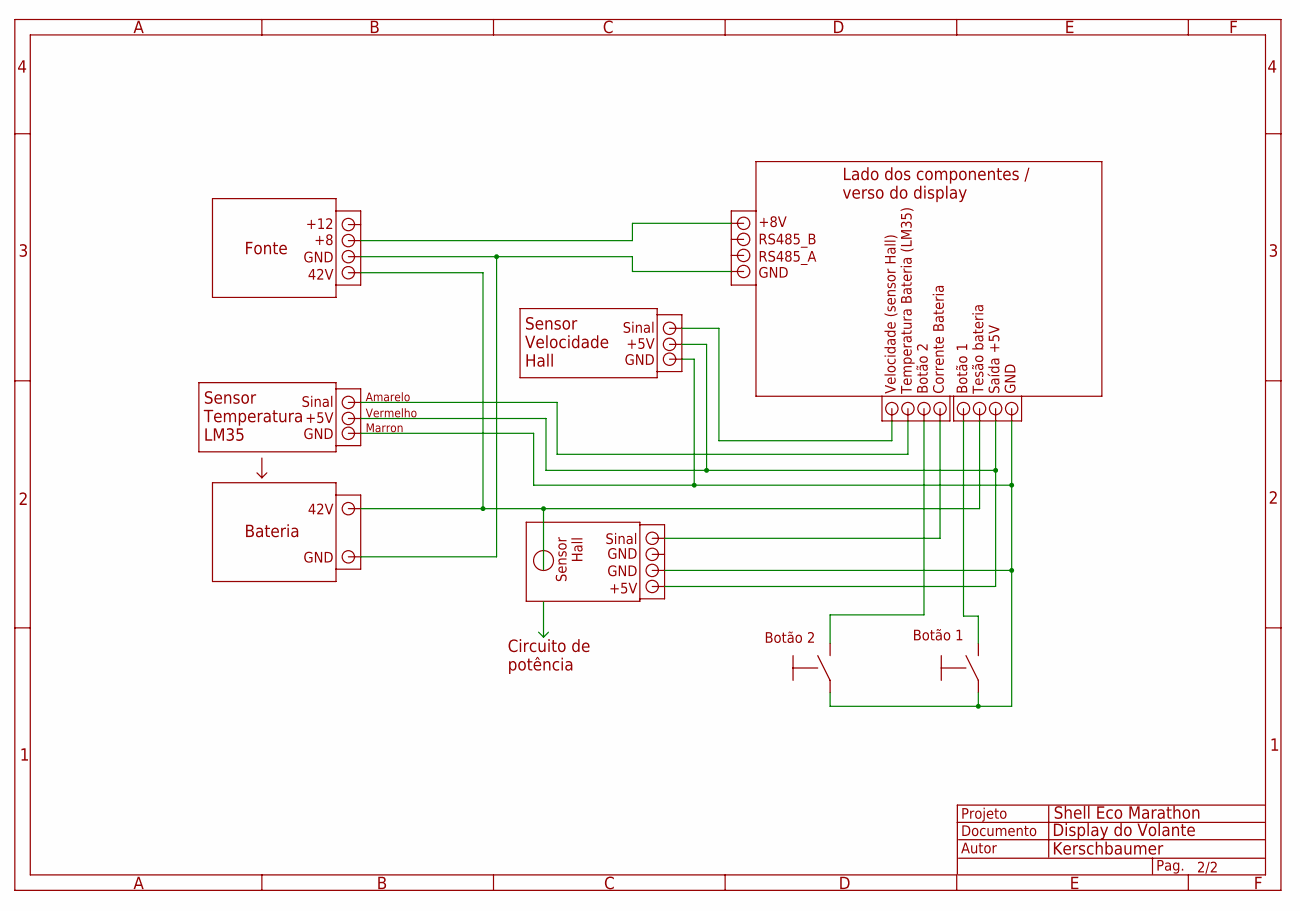
[picture p24: schematic DisplayVolanteVE.sch, sheet 2]

Notes on the sheet:
Shell Eco Marathon
Display do Volante
Kerschbaumer
Lado dos componentes / verso do display
+8V
RS485_A
RS485_B
GND
Saída +5V
Tesão bateria
Botão 1
Corrente Bateria
Botão 2
Temperatura Bateria (LM35)
Velocidade (sensor Hall)
42V
+12
Bateria
Fonte
Circuito de potência
Sensor Hall
+5V
Sinal
Sensor Temperatura LM35
Sensor Velocidade Hall
Amarelo
Vermelho
Marron

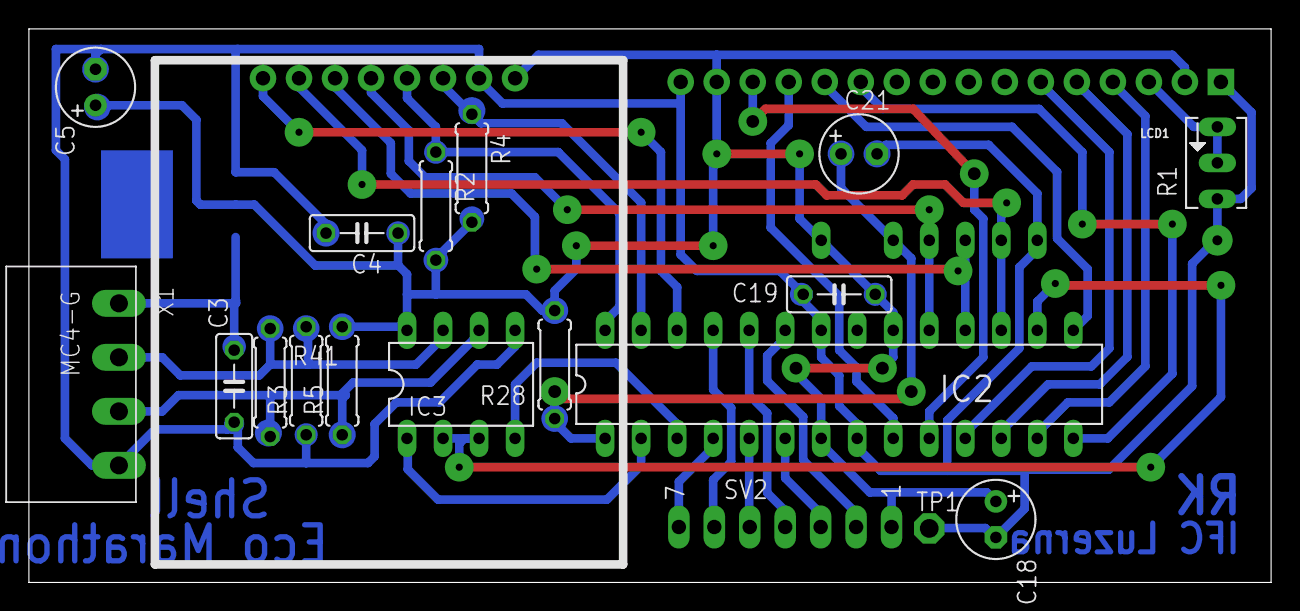
[picture p25: board DisplayVolanteVE.brd from above]

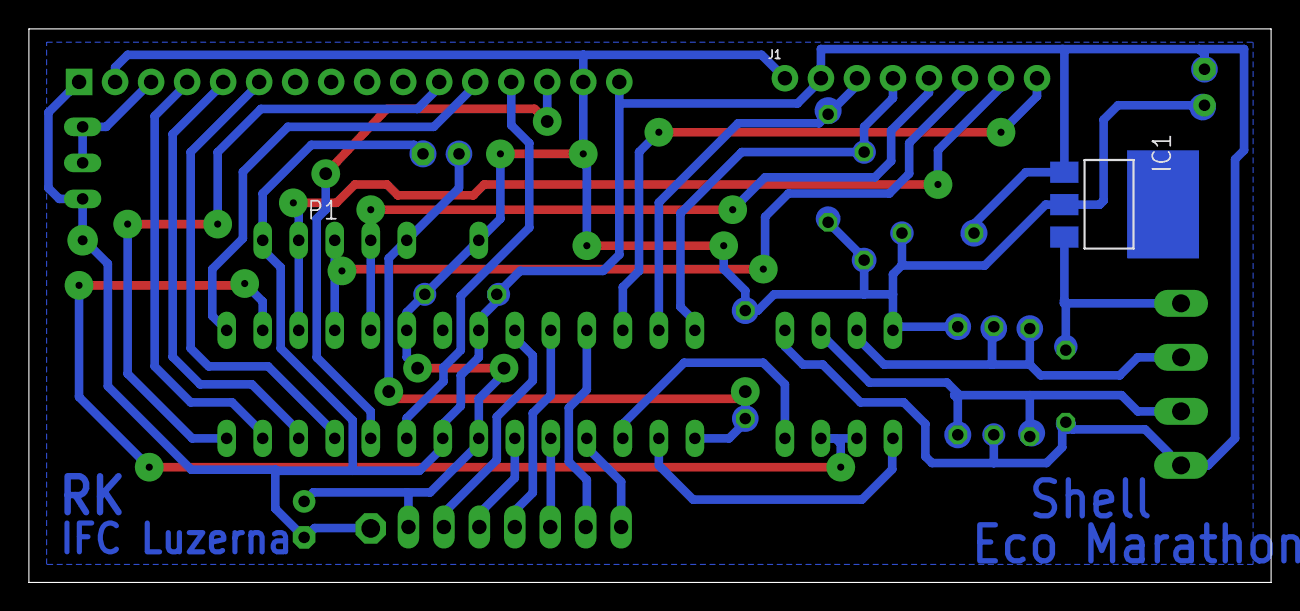
[picture p26: board DisplayVolanteVE.brd from below]

Board: 2 copper layers, 87.6 x 39.0 mm, 22 parts (3 on the bottom side), 29 nets.
