RicardoKers/TelemetriaVeiculoEletrico/Circuito/Fonte/Fonte.brd

## EAGLE design Circuito/Fonte/Fonte.brd (2022-04-19)

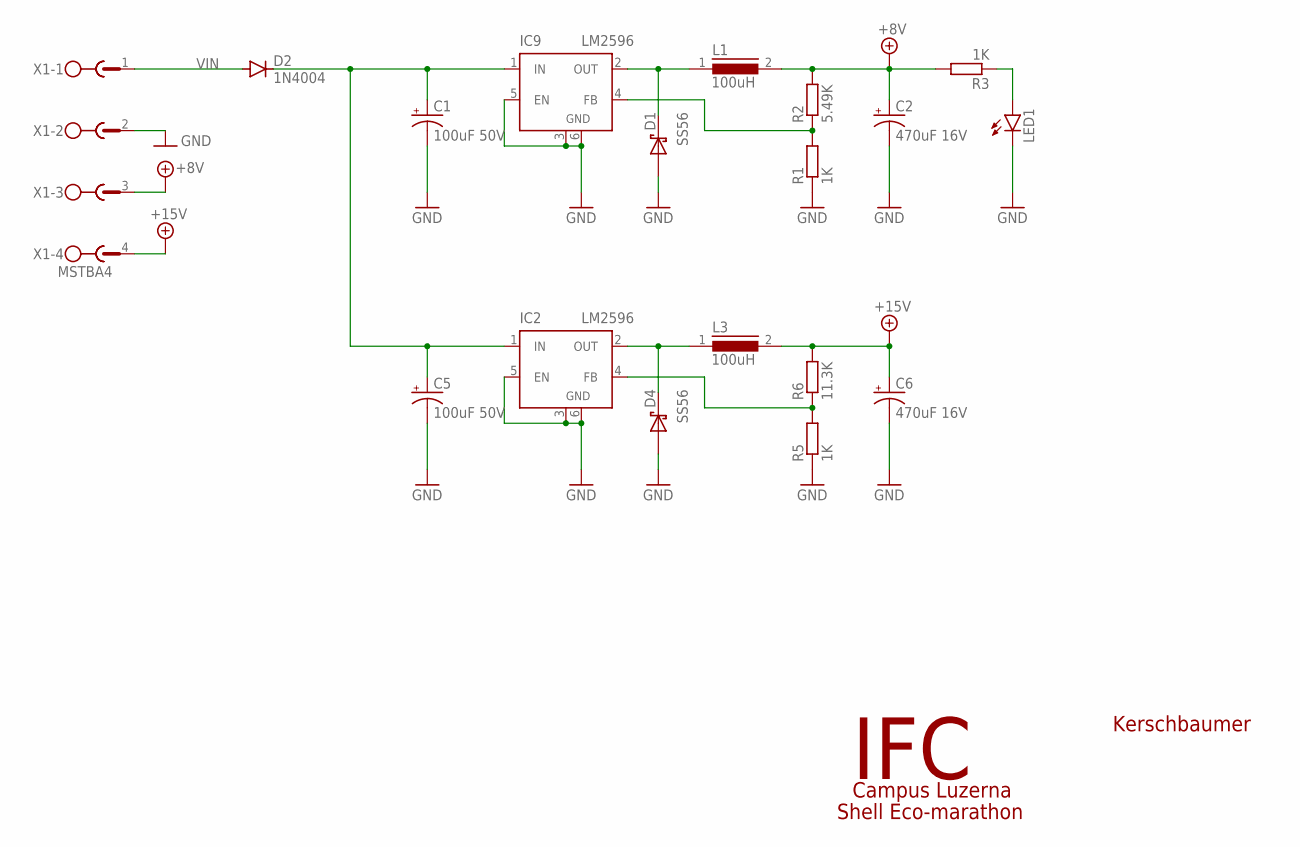
[picture p27: schematic Fonte.sch]

Parts:
C1, C5: 100uF 50V; E2,5-7
C2, C6: 470uF 16V; E2,5-7
D1, D4: SS56; SMA-DIODE
D2: 1N4004; DO41-10
IC2, IC9: LM2596; TO263-5
L1, L3: 100uH; DR125
LED1: LED3MM
R1, R3, R5: 1K; 0207/7
R2: 5.49K; 0207/7
R6: 11.3K; 0207/7
X1: MSTBA4

Connections:
+8V: C2.+, L1.2, R2.2, R3.2, X1.3
+15V: C6.+, L3.2, R6.2, X1.4
GND: C1.-, C2.-, C5.-, C6.-, D1.A, D4.A, IC2.3 (GND), IC2.5 (EN), IC2.6 (GND), IC9.3 (GND), IC9.5 (EN), IC9.6 (GND), LED1.K (C), R1.1, R5.1, X1.2
unnamed: C1.+, C5.+, D2.C, IC2.1 (IN), IC9.1 (IN)
unnamed: IC9.4 (FB), R1.2, R2.1
unnamed: D1.C, IC9.2 (OUT), L1.1
unnamed: LED1.A, R3.1
unnamed: IC2.4 (FB), R5.2, R6.1
unnamed: D4.C, IC2.2 (OUT), L3.1
VIN: D2.A, X1.1

Notes on the sheet:
Kerschbaumer
IFC
Shell Eco-marathon
Campus Luzerna

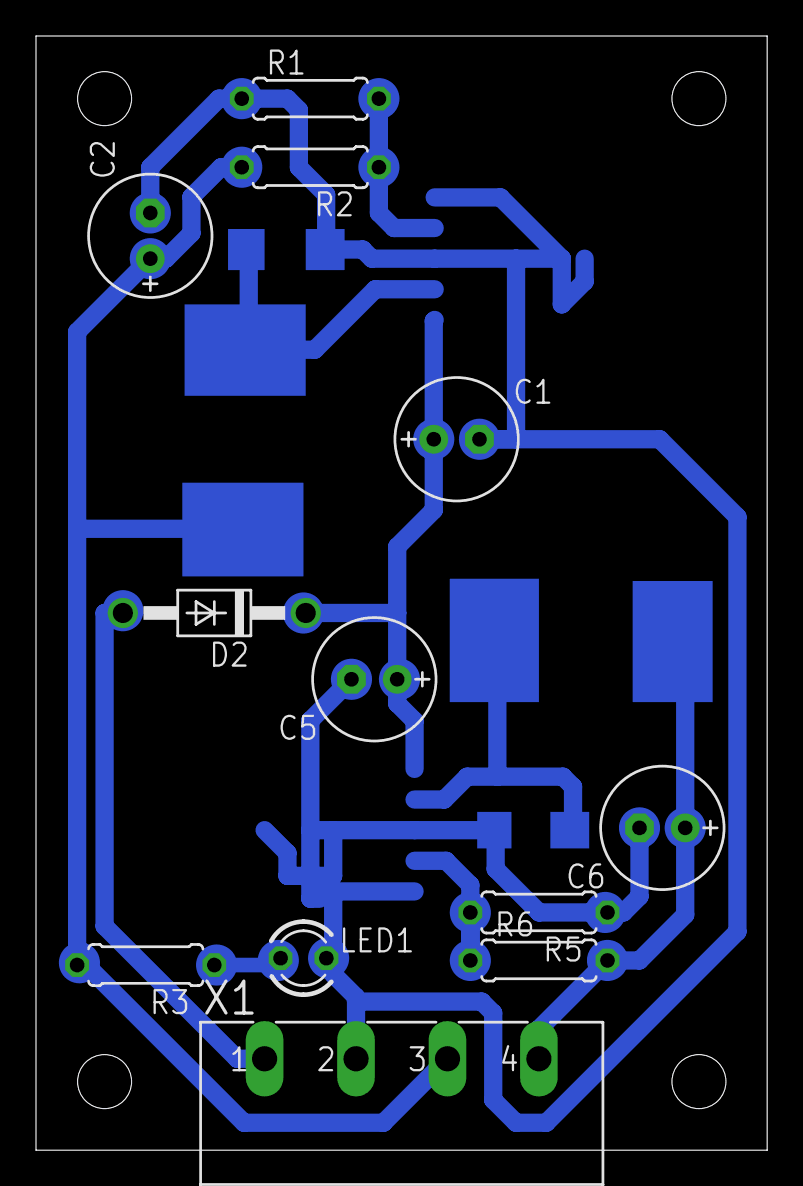
[picture p28: board Fonte.brd from above]

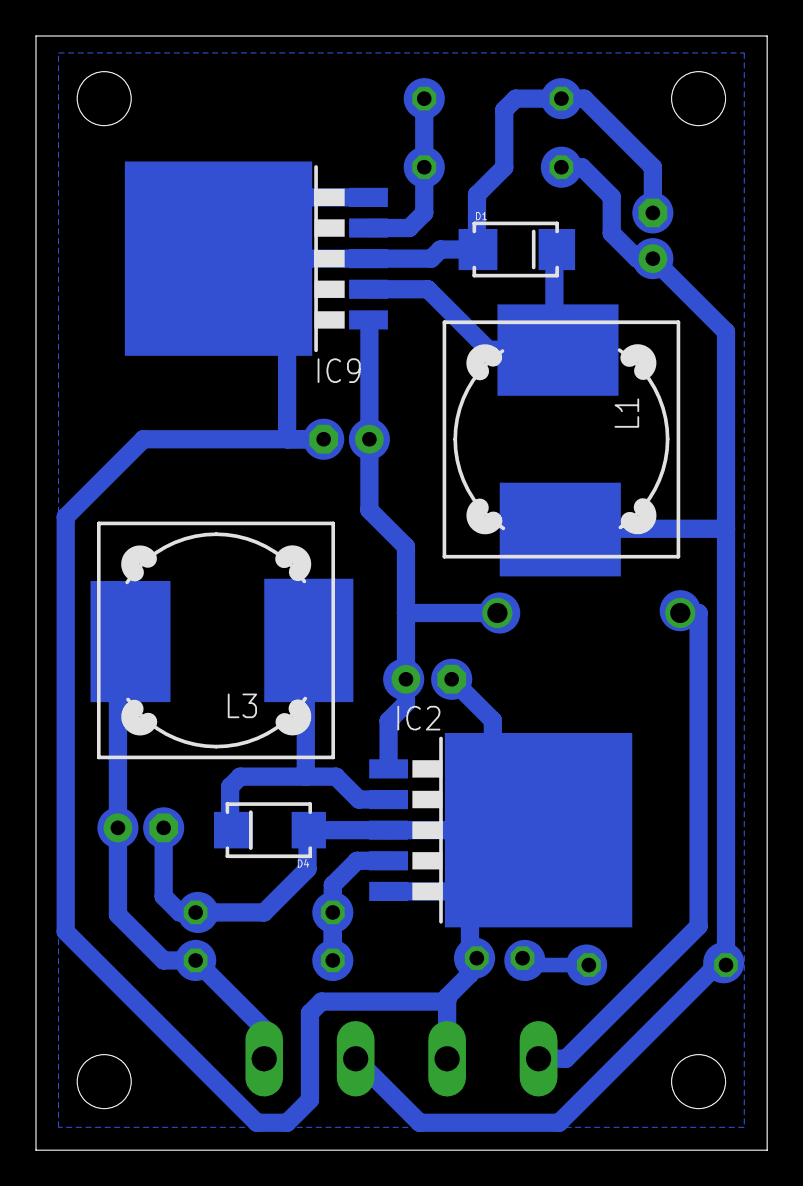
[picture p29: board Fonte.brd from below]

Board: 2 copper layers, 40.6 x 61.9 mm, 18 parts (6 on the bottom side), 10 nets.
