RicardoKers/TelemetriaVeiculoEletrico/programa uC/IHM/IHM/TextLCD.h

// Text LDC display in 4 bit mode om AVR microcotroller
// Version 2019-1

// data pin 4 from LCD
#define LCD_DATA_PORT4_H PORTB|=0b00000001
#define LCD_DATA_PORT4_L PORTB&=~0b00000001
#define LCD_DATA_DIRECTION4 DDRB|=0b00000001
// data pin 5 from LCD
#define LCD_DATA_PORT5_H PORTB|=0b00000010
#define LCD_DATA_PORT5_L PORTB&=~0b00000010
#define LCD_DATA_DIRECTION5 DDRB|=0b00000010
// data pin 6 from LCD
#define LCD_DATA_PORT6_H PORTB|=0b01000000
#define LCD_DATA_PORT6_L PORTB&=~0b01000000
#define LCD_DATA_DIRECTION6 DDRB|=0b01000000
// data pin 7 from LCD
#define LCD_DATA_PORT7_H PORTB|=0b10000000
#define LCD_DATA_PORT7_L PORTB&=~0b10000000
#define LCD_DATA_DIRECTION7 DDRB|=0b10000000

// E pin from LCD
#define LCD_E_H PORTD|=0b00100000
#define LCD_E_L PORTD&=~0b00100000
#define LCD_E_DIRECTION DDRD|=0b00100000

// RS pin from LCD
#define LCD_RS_H PORTD|=0b10000000
#define LCD_RS_L PORTD&=~0b10000000
#define LCD_RS_DIRECTION DDRD|=0b10000000

// connect R/W pin to GND

// Number of LCD columns
#define LCD_columns 20

//////////////////////////////////////////////////////////////////////////////////////////////////
//                              L C D   P U T   I N S T
//////////////////////////////////////////////////////////////////////////////////////////////////
static void LCD_put_inst(unsigned char cmd)
{
	_delay_us(50);
	LCD_RS_L;
	// bit 4
	if((cmd&0b00010000)!=0) LCD_DATA_PORT4_H;
	else LCD_DATA_PORT4_L;
	// bit 5
	if((cmd&0b00100000)!=0) LCD_DATA_PORT5_H;
	else LCD_DATA_PORT5_L;
	// bit 6
	if((cmd&0b01000000)!=0) LCD_DATA_PORT6_H;
	else LCD_DATA_PORT6_L;
	// bit 7
	if((cmd&0b10000000)!=0) LCD_DATA_PORT7_H;
	else LCD_DATA_PORT7_L;
	LCD_E_H;
	//_delay_us(1);
	LCD_E_L;
	// bit 0
	if((cmd&0b00000001)!=0) LCD_DATA_PORT4_H;
	else LCD_DATA_PORT4_L;
	// bit 1
	if((cmd&0b00000010)!=0) LCD_DATA_PORT5_H;
	else LCD_DATA_PORT5_L;
	// bit 2
	if((cmd&0b00000100)!=0) LCD_DATA_PORT6_H;
	else LCD_DATA_PORT6_L;
	// bit 3
	if((cmd&0b00001000)!=0) LCD_DATA_PORT7_H;
	else LCD_DATA_PORT7_L;
	LCD_E_H;
	//_delay_us(1);
	LCD_E_L;
}

//////////////////////////////////////////////////////////////////////////////////////////////////
//                               L C D   P U T C H A R
//////////////////////////////////////////////////////////////////////////////////////////////////
void LCD_putchar(char c)
{
	_delay_us(50);
	LCD_RS_H;
	// bit 4
	if((c&0b00010000)!=0) LCD_DATA_PORT4_H;
	else LCD_DATA_PORT4_L;
	// bit 5
	if((c&0b00100000)!=0) LCD_DATA_PORT5_H;
	else LCD_DATA_PORT5_L;
	// bit 6
	if((c&0b01000000)!=0) LCD_DATA_PORT6_H;
	else LCD_DATA_PORT6_L;
	// bit 7
	if((c&0b10000000)!=0) LCD_DATA_PORT7_H;
	else LCD_DATA_PORT7_L;
	LCD_E_H;
	//_delay_us(1);
	LCD_E_L;
	// bit 0
	if((c&0b00000001)!=0) LCD_DATA_PORT4_H;
	else LCD_DATA_PORT4_L;
	// bit 1
	if((c&0b00000010)!=0) LCD_DATA_PORT5_H;
	else LCD_DATA_PORT5_L;
	// bit 2
	if((c&0b00000100)!=0) LCD_DATA_PORT6_H;
	else LCD_DATA_PORT6_L;
	// bit 3
	if((c&0b00001000)!=0) LCD_DATA_PORT7_H;
	else LCD_DATA_PORT7_L;
	LCD_E_H;
	//_delay_us(1);
	LCD_E_L;
}

//////////////////////////////////////////////////////////////////////////////////////////////////
//                                    C L R  L C D
//////////////////////////////////////////////////////////////////////////////////////////////////
void clr_lcd()
{
	LCD_put_inst(0x01);
}

//////////////////////////////////////////////////////////////////////////////////////////////////
//                                  G O T O X Y
//////////////////////////////////////////////////////////////////////////////////////////////////
void gotoxy(char x,char y)
{
	if(y==0)
	{
		LCD_put_inst(0x80+x);
	}
	if(y==1)
	{
		LCD_put_inst(0xC0+x);
	}
	if(y==2)
	{
		LCD_put_inst(0x80+LCD_columns+x);
	}
	if(y==3)
	{
		LCD_put_inst(0xC0+LCD_columns+x);
	}
}

//////////////////////////////////////////////////////////////////////////////////////////////////
//                               E S P E C I A L  C H A R
//////////////////////////////////////////////////////////////////////////////////////////////////
static void especial_char(char addr, char L1,char L2,char L3,char L4,char L5,char L6,char L7,char L8)
{
	addr=addr*8+0x40;
	LCD_put_inst(addr);
	LCD_putchar(L1);
	LCD_putchar(L2);
	LCD_putchar(L3);
	LCD_putchar(L4);
	LCD_putchar(L5);
	LCD_putchar(L6);
	LCD_putchar(L7);
	LCD_putchar(L8);
}

//////////////////////////////////////////////////////////////////////////////////////////////////
//                               P U T S T R
////////////////////////////////////////////////////////////////////////////////////////
void putstr(char *str)
{
	int cont=0;
	while(str[cont]!=0&&cont<1000)
	{
		LCD_putchar(str[cont]);
		cont++;
	}
}

//////////////////////////////////////////////////////////////////////////////////////////////////
//                               P U T U I N T
//////////////////////////////////////////////////////////////////////////////////////////////////
void putuint(unsigned int data)
{
	char str[11];
	int cont=0;

	if(data>999999999)
	{
		str[cont]=(char)((data/1000000000)+48);//10
		cont++;
	}
	if(data>99999999)
	{
		str[cont]=(char)((data%1000000000/100000000)+48);//9
		cont++;
	}
	if(data>9999999)
	{
		str[cont]=(char)((data%100000000/10000000)+48);//8
		cont++;
	}
	if(data>999999)
	{
		str[cont]=(char)((data%10000000/1000000)+48);//7
		cont++;
	}
	if(data>99999)
	{
		str[cont]=(char)((data%1000000/100000)+48);//6
		cont++;
	}
	if(data>9999)
	{
		str[cont]=(char)((data%100000/10000)+48);//5
		cont++;
	}
	if(data>999)
	{
		str[cont]=(char)(((data%10000)/1000)+48);//4
		cont++;
	}
	if(data>99)
	{
		str[cont]=(char)(((data%1000)/100)+48);//3
		cont++;
	}
	if(data>9)
	{
		str[cont]=(char)(((data%100)/10)+48);//2
		cont++;
	}
	str[cont]=(char)((data%10)+48);//1
	cont++;
	str[cont]=0;
	putstr(str);
}

//////////////////////////////////////////////////////////////////////////////////////////////////
//                               P U T I N T
//////////////////////////////////////////////////////////////////////////////////////////////////
void putint(int data)
{
	char str[12];
	int cont=0;
	if(data<0)
	{
		str[cont]='-';
		cont++;
		data=data*(-1);
	}
	if(data>999999999)
	{
		str[cont]=(char)((data/1000000000)+48);//10
		cont++;
	}
	if(data>99999999)
	{
		str[cont]=(char)((data%1000000000/100000000)+48);//9
		cont++;
	}
	if(data>9999999)
	{
		str[cont]=(char)((data%100000000/10000000)+48);//8
		cont++;
	}
	if(data>999999)
	{
		str[cont]=(char)((data%10000000/1000000)+48);//7
		cont++;
	}
	if(data>99999)
	{
		str[cont]=(char)((data%1000000/100000)+48);//6
		cont++;
	}
	if(data>9999)
	{
		str[cont]=(char)((data%100000/10000)+48);//5
		cont++;
	}
	if(data>999)
	{
		str[cont]=(char)(((data%10000)/1000)+48);//4
		cont++;
	}
	if(data>99)
	{
		str[cont]=(char)(((data%1000)/100)+48);//3
		cont++;
	}
	if(data>9)
	{
		str[cont]=(char)(((data%100)/10)+48);//2
		cont++;
	}
	str[cont]=(char)((data%10)+48);//1
	cont++;
	str[cont]=0;
	putstr(str);
}

//////////////////////////////////////////////////////////////////////////////////////////////////
//                               P U T I N T D E C
//////////////////////////////////////////////////////////////////////////////////////////////////
void putintdec(int num)
{
	putint(num/10);
	LCD_putchar('.');
	putint(num-((num/10)*10));	
}


//////////////////////////////////////////////////////////////////////////////////////////////////
//                               L C D   i n i t
//////////////////////////////////////////////////////////////////////////////////////////////////
void LCD_init()
{
	unsigned int i;
	char initdata[] = {0x33, 0x32, 0x28, 0x0C, 0x01, 0x06, 0x80};

	_delay_ms(16);

	LCD_DATA_DIRECTION4;
	LCD_DATA_DIRECTION5;
	LCD_DATA_DIRECTION6;
	LCD_DATA_DIRECTION7;
	LCD_E_DIRECTION;
	LCD_RS_DIRECTION;
	LCD_E_H;
	LCD_RS_L;
	LCD_E_L;
	
	for (i = 0; i < sizeof initdata; ++i)
	{
		LCD_put_inst(initdata[i]);
		_delay_ms(16);
	}
}
