RicardoKers/TelemetriaVeiculoEletrico/(commit log)

2019-05-16 mais testes
    [PlacaAquisicao.brd, PlacaAquisicao.sch]
2022-08-31 versão 2022
    [BLDC - Copia.simu, BLDC 2.simu, BLDC velho.simu, DisplayVolanteVE.brd, DisplayVolanteVE.sch, Final Driver Concept.brd, Final Driver Concept.sch, Final.brd]
